cameronmorgzz-web/OpenFrontIOmobile/cad/renders/button.png

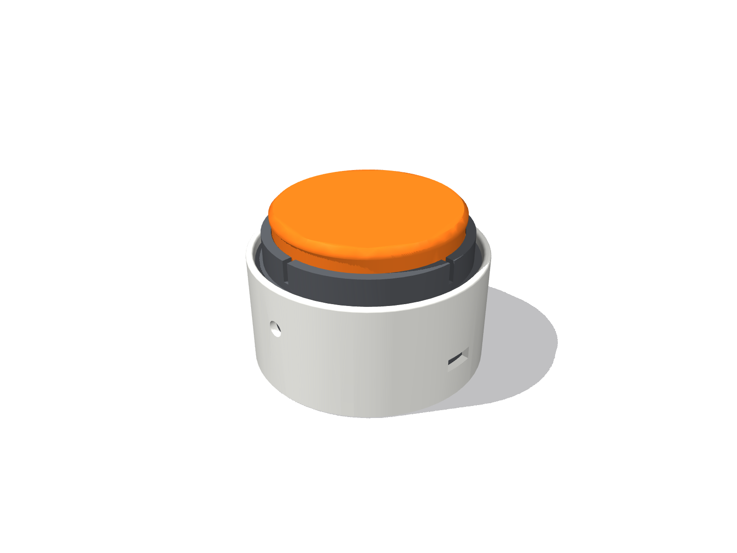
cad/renders/button.png
