cameronmorgzz-web/OpenFrontIOmobile/cad/renders/button_exploded.png

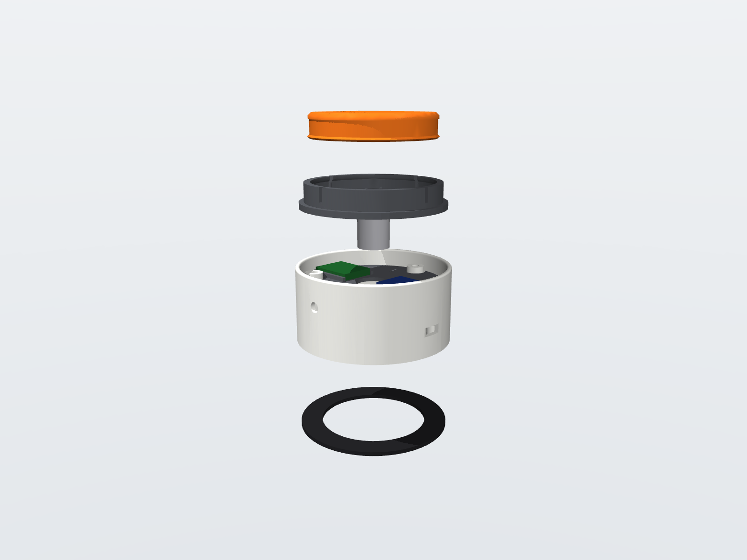
cad/renders/button_exploded.png
