cameronmorgzz-web/OpenFrontIOmobile/cad/renders/launcher_exploded.png

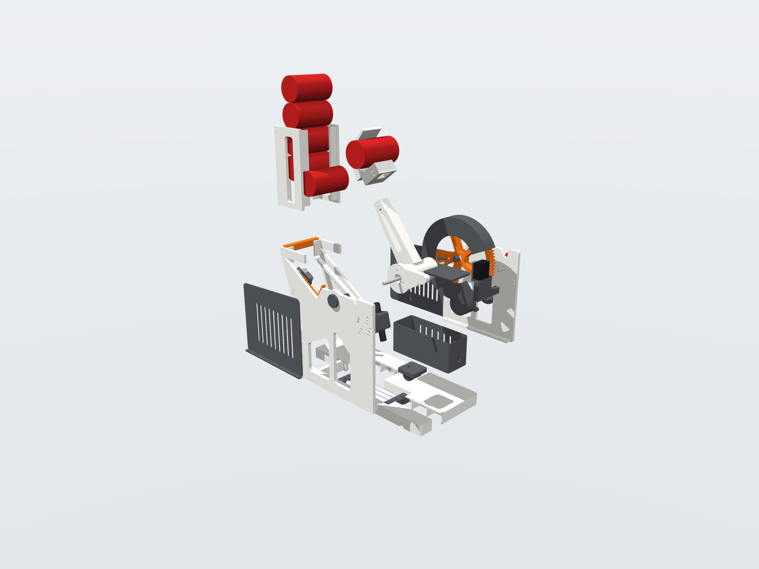
cad/renders/launcher_exploded.png
