cameronmorgzz-web/OpenFrontIOmobile/cad/renders/launcher_rear_right.png

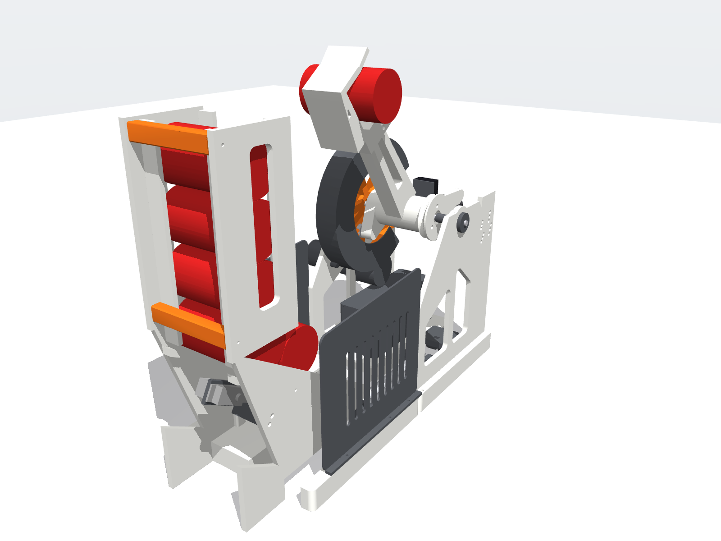
cad/renders/launcher_rear_right.png
