cameronmorgzz-web/OpenFrontIOmobile/cad/renders/launcher_side.png

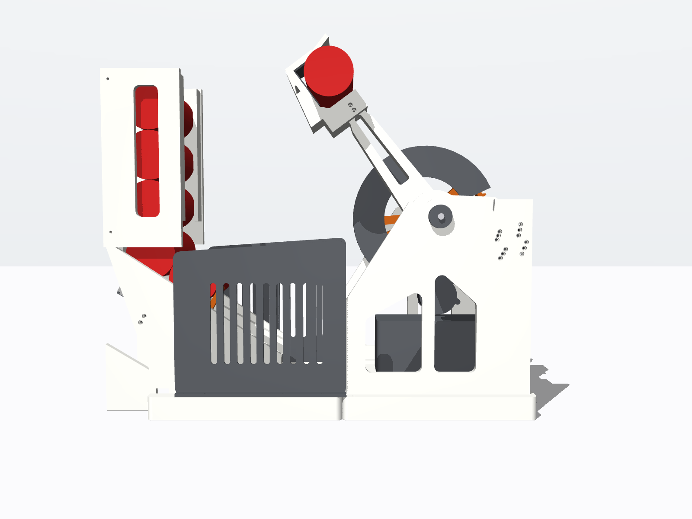
cad/renders/launcher_side.png
