cameronmorgzz-web/OpenFrontIOmobile/cad/renders/launcher_top.png

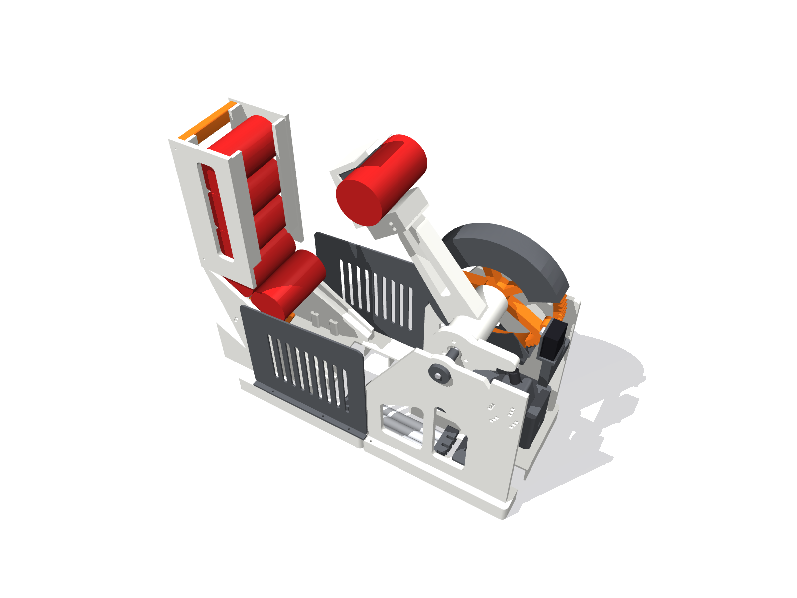
cad/renders/launcher_top.png
