cameronmorgzz-web/OpenFrontIOmobile/calc/plots/swing_4m.png

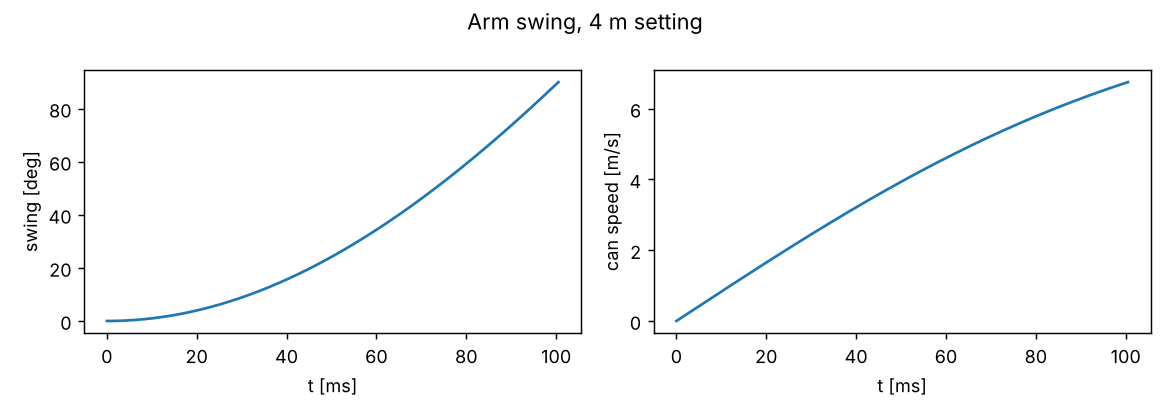
calc/plots/swing_4m.png
