cameronmorgzz-web/OpenFrontIOmobile/calc/plots/trajectories.png

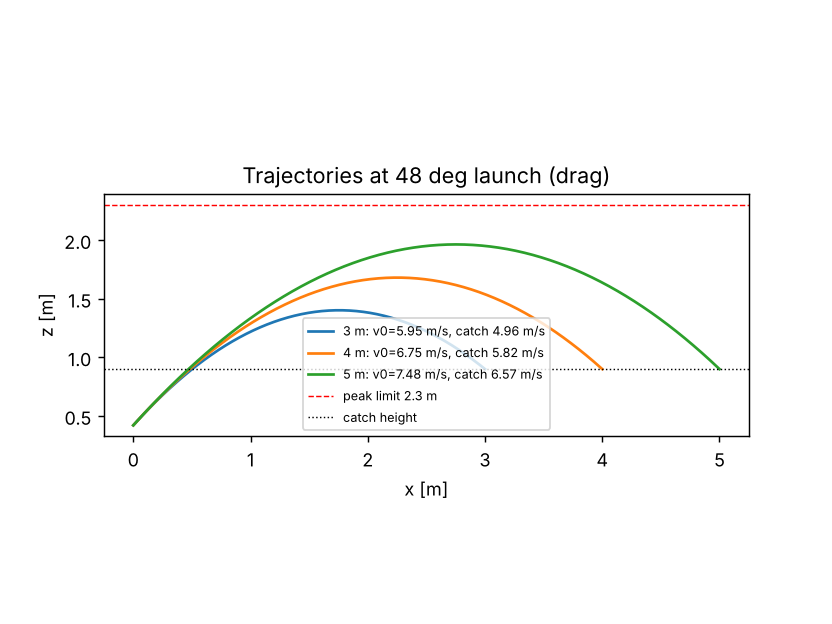
calc/plots/trajectories.png
