cameronmorgzz-web/OpenFrontIOmobile/sim/plots/feed_sim.png

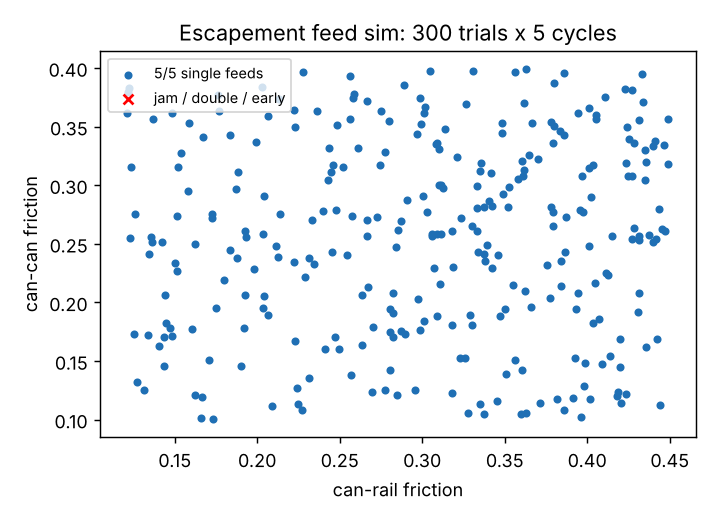
sim/plots/feed_sim.png
