cameronmorgzz-web/OpenFrontIOmobile/sim/plots/monte_carlo_4m.png

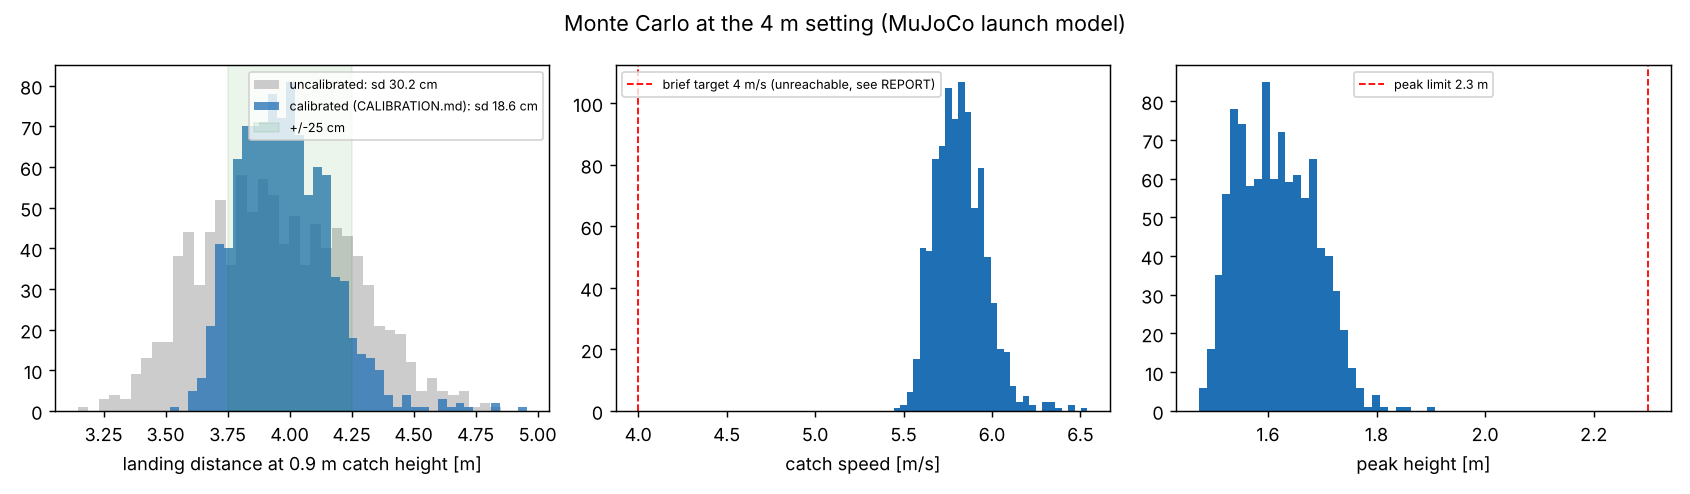
sim/plots/monte_carlo_4m.png
