cameronmorgzz-web/OpenFrontIOmobile/cad/step/launcher_assembly.step

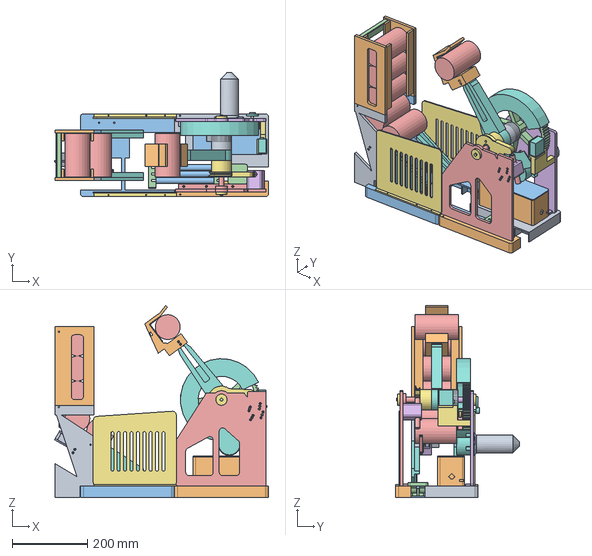
[picture p12: CAD file, 2026-10-26]
cad/step/launcher_assembly.step
568.7 x 330.0 x 510.2 mm
