cameronmorgzz-web/OpenFrontIOmobile/cad/3mf/plate_PETG_13.3mf

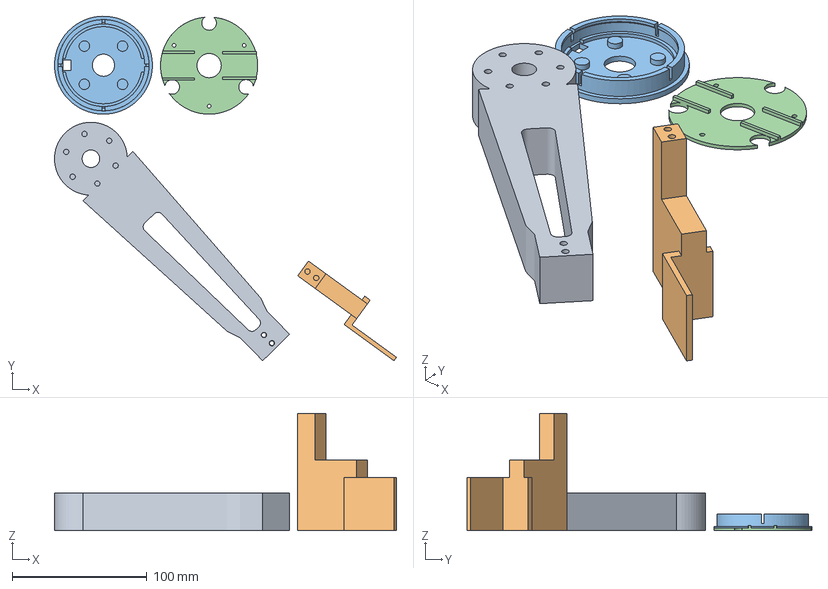
[picture p13: CAD file, 2026-10-26]
cad/3mf/plate_PETG_13.3mf
253.4 x 255.3 x 87.0 mm
arm
latch_servo_mount
btn_switch_plate
btn_tray
