cameronmorgzz-web/OpenFrontIOmobile/cad/step/btn_switch_plate.step

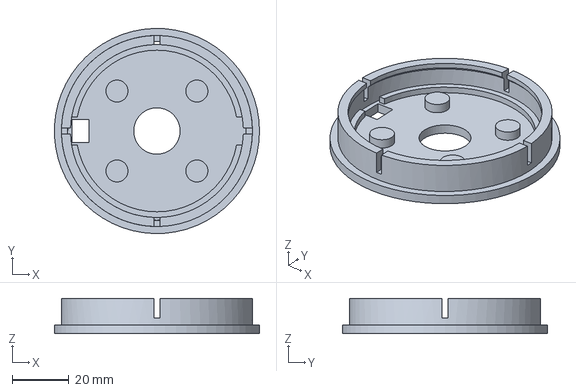
[picture p14: CAD file, 2026-10-26]
cad/step/btn_switch_plate.step
72.5 x 72.6 x 12.5 mm
