cameronmorgzz-web/OpenFrontIOmobile/cad/step/latch_servo_mount.step

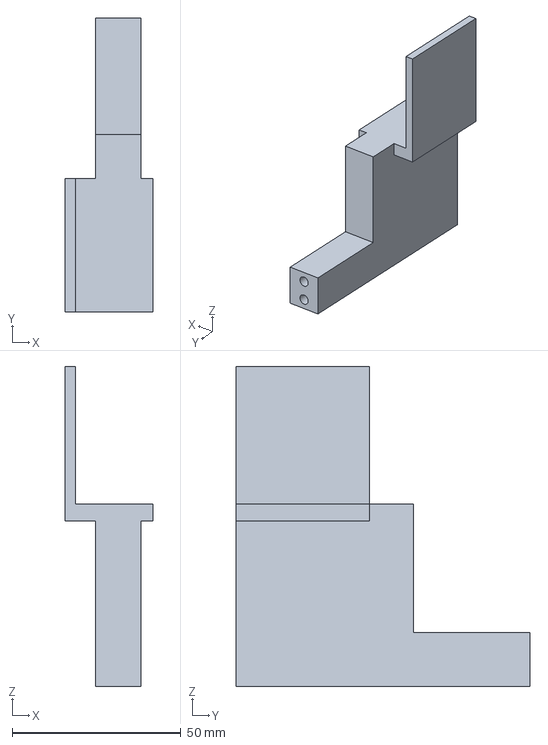
[picture p16: CAD file, 2026-10-26]
cad/step/latch_servo_mount.step
26.0 x 87.0 x 94.7 mm
