cameronmorgzz-web/OpenFrontIOmobile/cad/3mf/plate_PETG_8.3mf

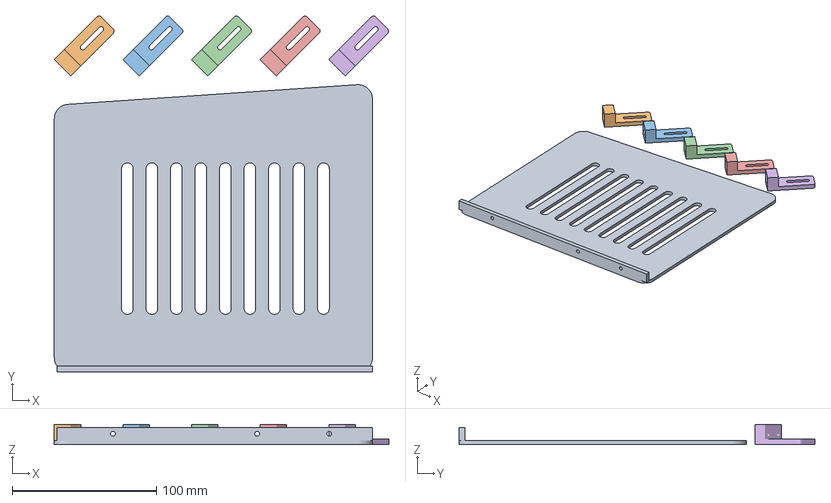
[picture p17: CAD file, 2026-10-26]
cad/3mf/plate_PETG_8.3mf
232.0 x 246.9 x 14.0 mm
side_cheek_left
switch_bracket x 5
