cameronmorgzz-web/OpenFrontIOmobile/cad/3mf/plate_PETG_6.3mf

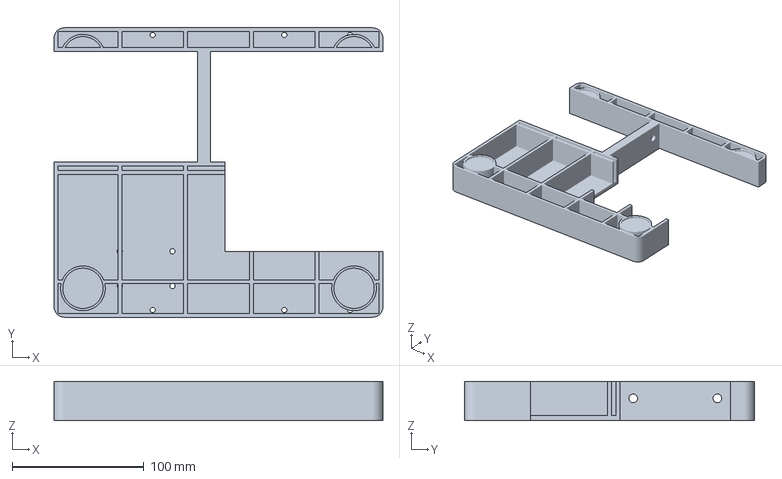
[picture p18: CAD file, 2026-10-26]
cad/3mf/plate_PETG_6.3mf
250.0 x 220.0 x 30.0 mm
