cameronmorgzz-web/OpenFrontIOmobile/cad/step/mag_chute_left.step

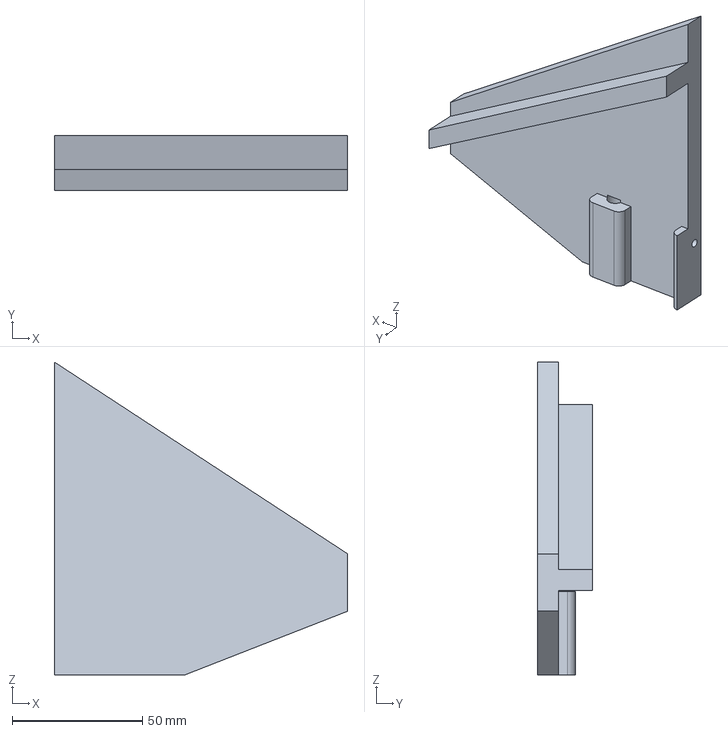
[picture p19: CAD file, 2026-10-26]
cad/step/mag_chute_left.step
112.5 x 21.0 x 120.1 mm
