cameronmorgzz-web/OpenFrontIOmobile/cad/3mf/plate_PETG_7.3mf

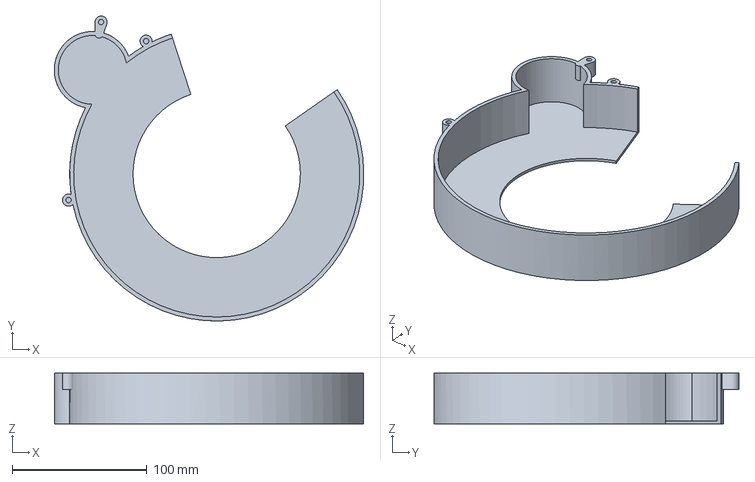
[picture p20: CAD file, 2026-10-26]
cad/3mf/plate_PETG_7.3mf
229.4 x 226.1 x 37.5 mm
