cameronmorgzz-web/OpenFrontIOmobile/cad/step/sensor_bracket.step

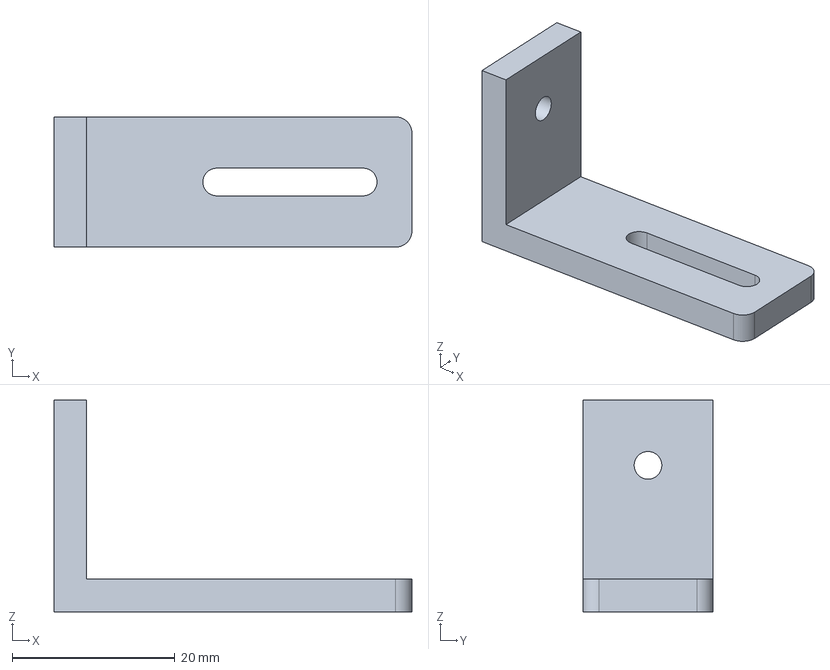
[picture p21: CAD file, 2026-10-26]
cad/step/sensor_bracket.step
44.0 x 16.0 x 26.0 mm
