cameronmorgzz-web/OpenFrontIOmobile/cad/3mf/plate_PETG_5.3mf

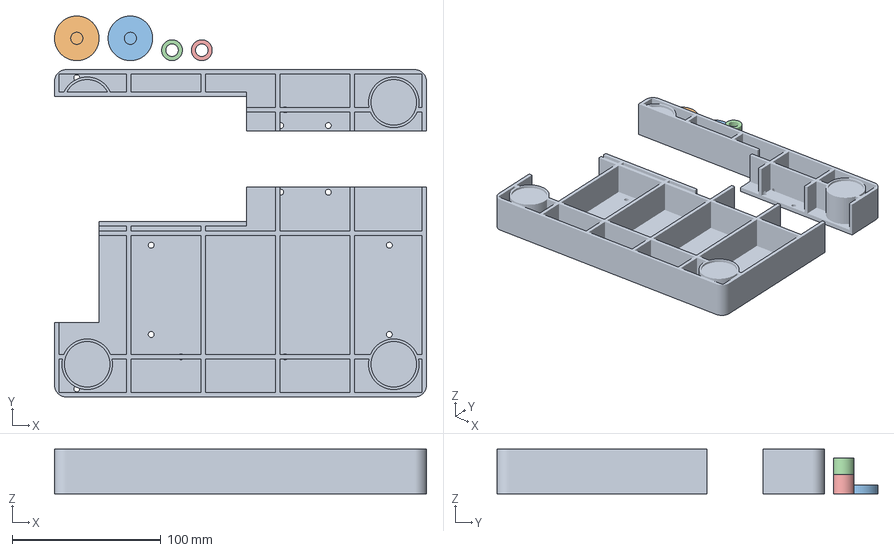
[picture p22: CAD file, 2026-10-26]
cad/3mf/plate_PETG_5.3mf
250.0 x 256.0 x 30.0 mm
base_front
shaft_cap_left
shaft_cap_right
shaft_spacer_left
shaft_spacer_mid
