cameronmorgzz-web/OpenFrontIOmobile/cad/3mf/plate_PETG_12.3mf

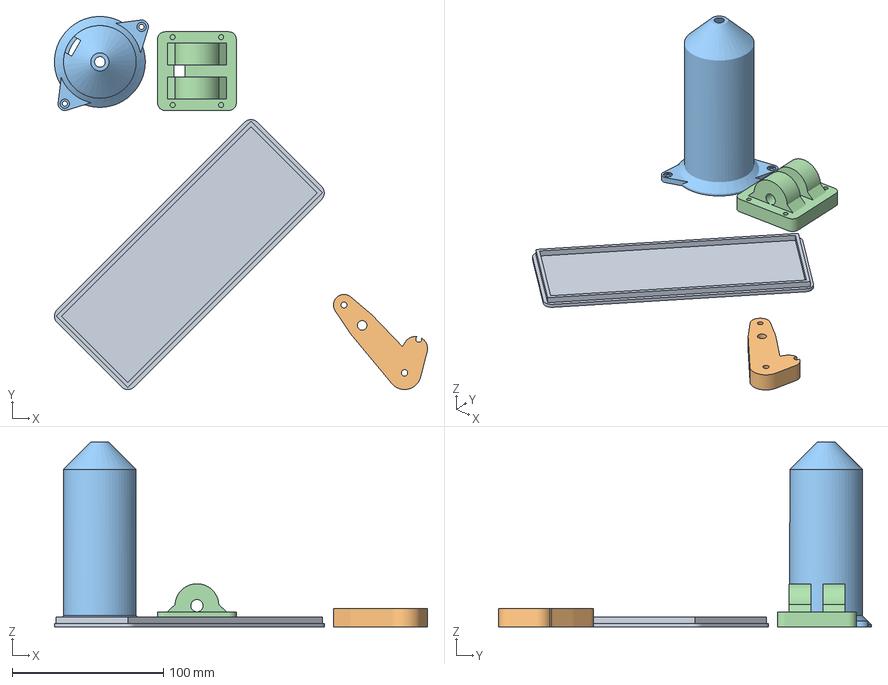
[picture p24: CAD file, 2026-10-26]
cad/3mf/plate_PETG_12.3mf
246.3 x 246.2 x 122.0 mm
ebox_lid
ring_latch
motor_cover
pulley_bracket
