cameronmorgzz-web/OpenFrontIOmobile/cad/step/ebox_lid.step

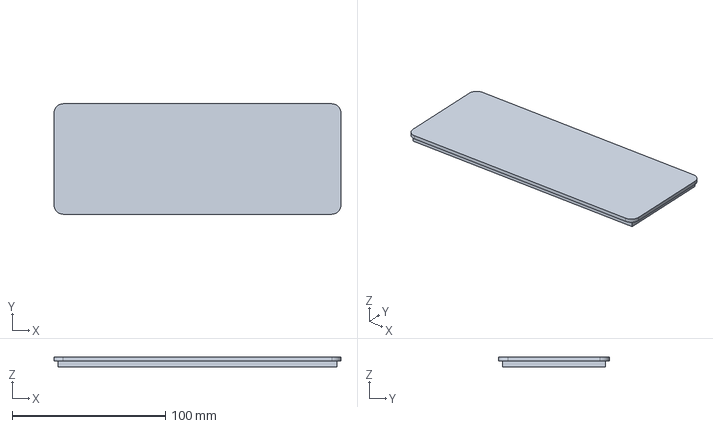
[picture p25: CAD file, 2026-10-26]
cad/step/ebox_lid.step
187.0 x 72.0 x 6.40 mm
