cameronmorgzz-web/OpenFrontIOmobile/cad/3mf/plate_PETG_16.3mf

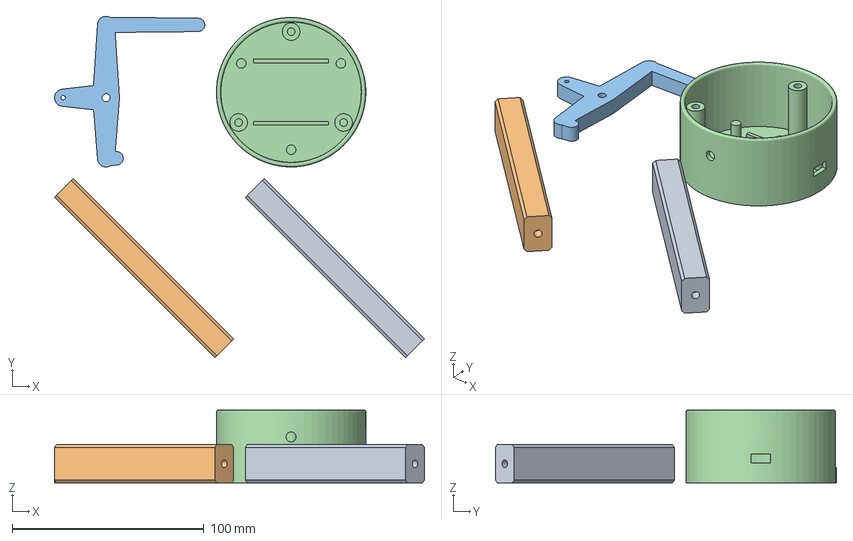
[picture p26: CAD file, 2026-10-26]
cad/3mf/plate_PETG_16.3mf
193.0 x 178.1 x 38.0 mm
mag_bridge_top
mag_bridge_back
escapement_rocker
btn_shell
