cameronmorgzz-web/OpenFrontIOmobile/cad/step/side_cheek_left.step

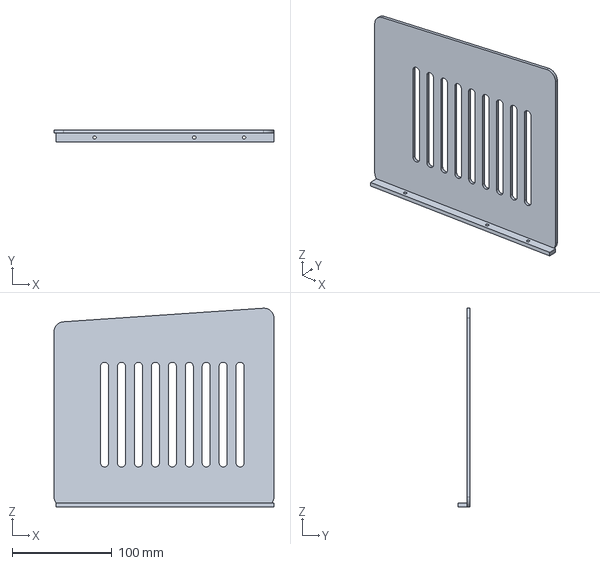
[picture p27: CAD file, 2026-10-26]
cad/step/side_cheek_left.step
220.7 x 12.0 x 199.3 mm
