cameronmorgzz-web/OpenFrontIOmobile/cad/3mf/plate_TPU_1.3mf

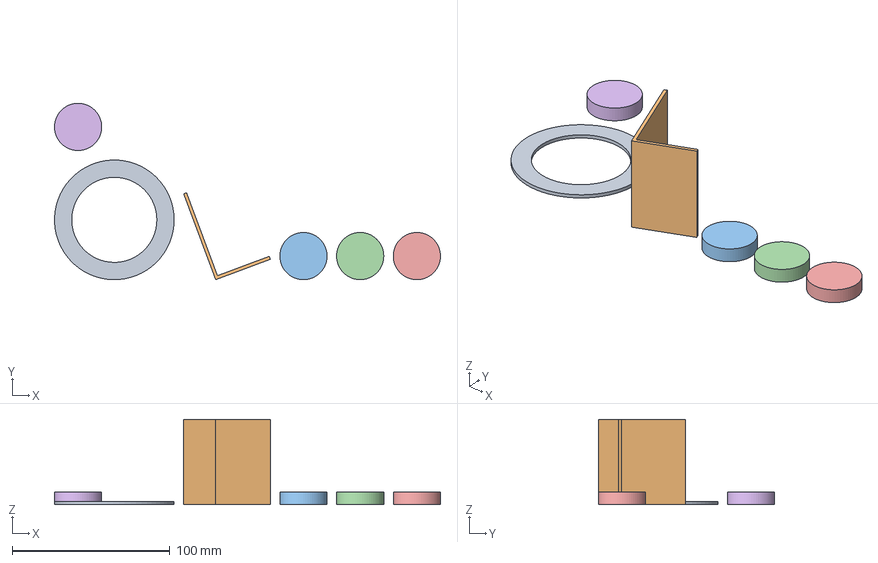
[picture p28: CAD file, 2026-10-26]
cad/3mf/plate_TPU_1.3mf
245.1 x 112.0 x 54.0 mm
btn_foot_ring
cup_pad
foot x 4
