cameronmorgzz-web/OpenFrontIOmobile/cad/step/ebox.step

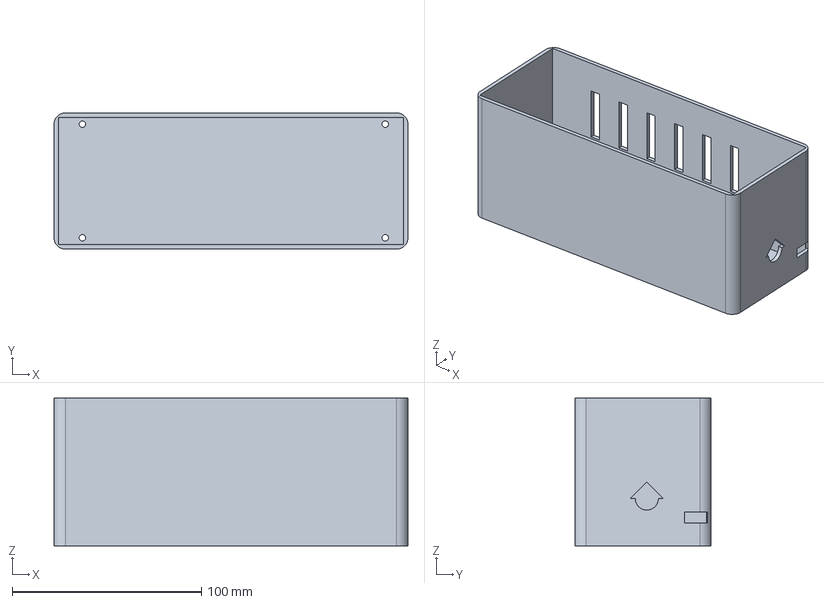
[picture p29: CAD file, 2026-10-26]
cad/step/ebox.step
187.0 x 72.0 x 78.0 mm
