cameronmorgzz-web/OpenFrontIOmobile/cad/3mf/plate_PETG_11.3mf

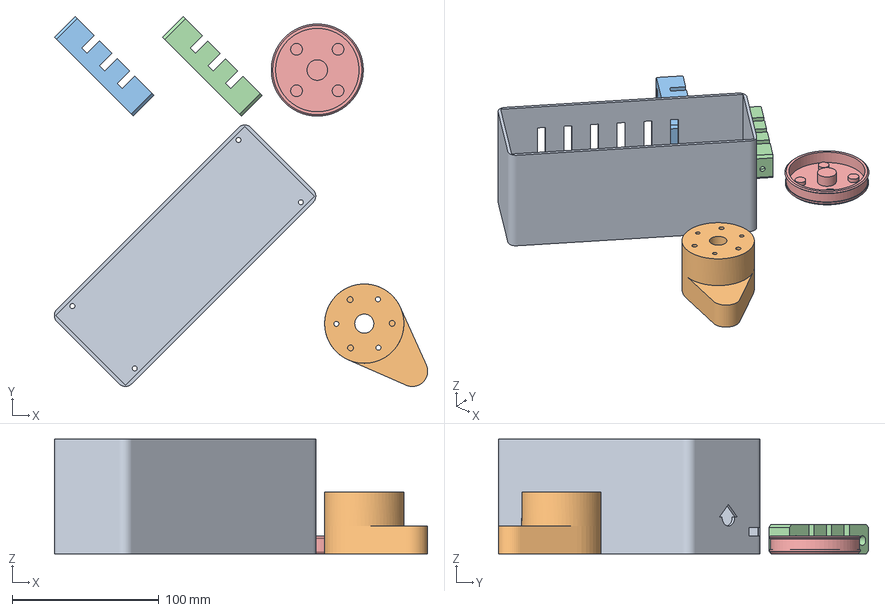
[picture p30: CAD file, 2026-10-26]
cad/3mf/plate_PETG_11.3mf
254.4 x 252.1 x 78.0 mm
ebox
hub_catch
spring_yoke_front
spring_yoke_rear
btn_cap
