cameronmorgzz-web/OpenFrontIOmobile/cad/step/mag_wall_right_upper.step

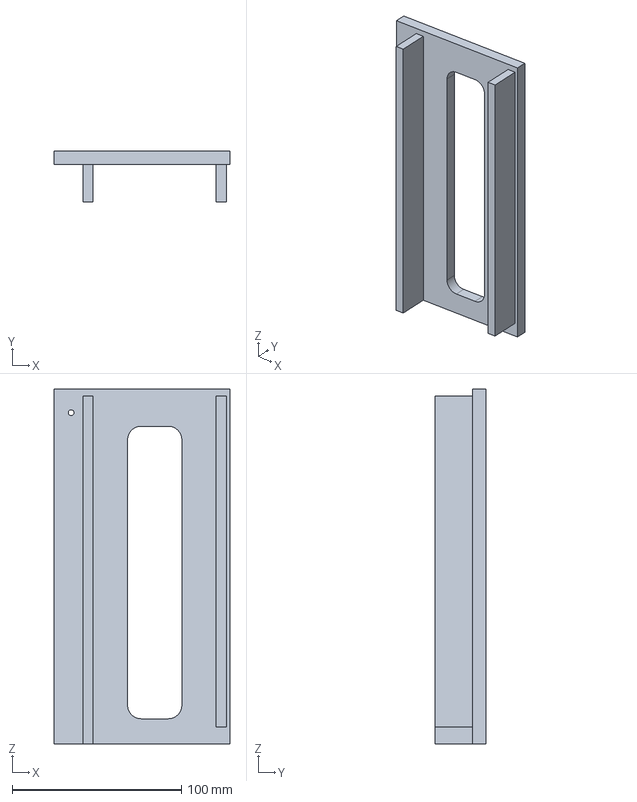
[picture p31: CAD file, 2026-10-26]
cad/step/mag_wall_right_upper.step
103.6 x 30.0 x 209.5 mm
