cameronmorgzz-web/OpenFrontIOmobile/cad/3mf/plate_PETG_15.3mf

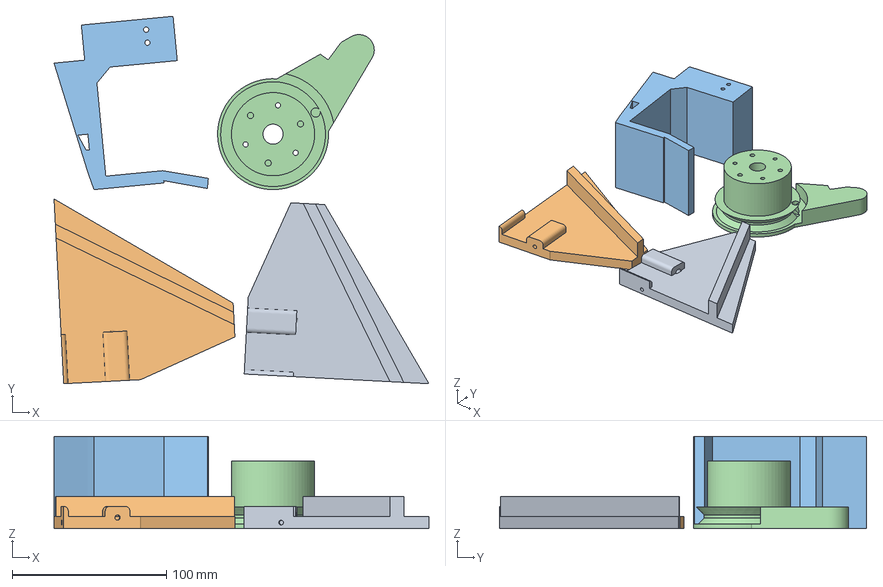
[picture p32: CAD file, 2026-10-26]
cad/3mf/plate_PETG_15.3mf
243.3 x 238.4 x 60.0 mm
mag_chute_left
mag_chute_right
cup
hub_drum
