cameronmorgzz-web/OpenFrontIOmobile/cad/step/pulley_bracket.step

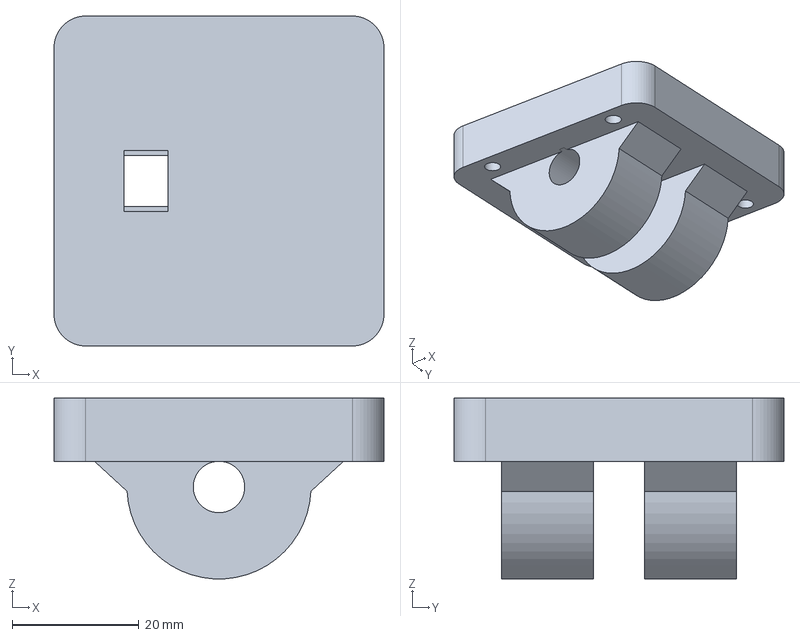
[picture p33: CAD file, 2026-10-26]
cad/step/pulley_bracket.step
52.0 x 52.0 x 28.5 mm
