cameronmorgzz-web/OpenFrontIOmobile/cad/3mf/plate_PETG_4.3mf

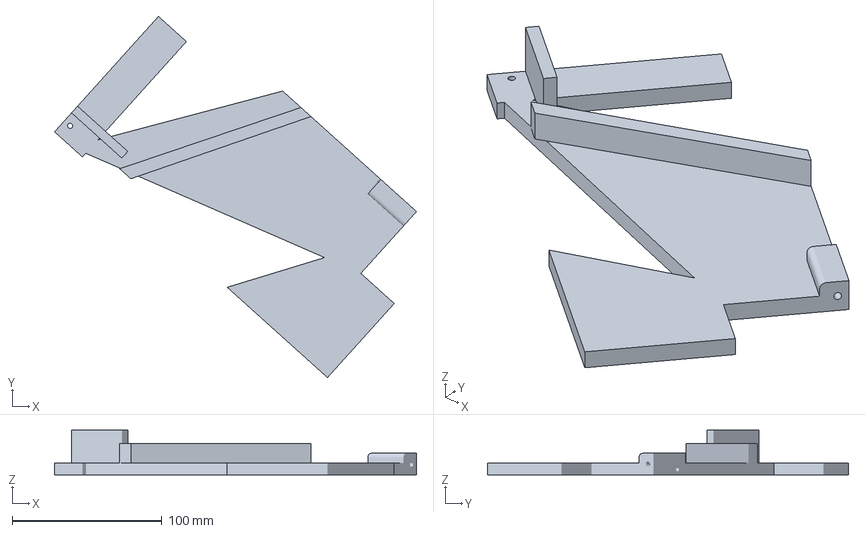
[picture p34: CAD file, 2026-10-26]
cad/3mf/plate_PETG_4.3mf
241.4 x 240.9 x 30.0 mm
