cameronmorgzz-web/OpenFrontIOmobile/cad/step/base_front.step

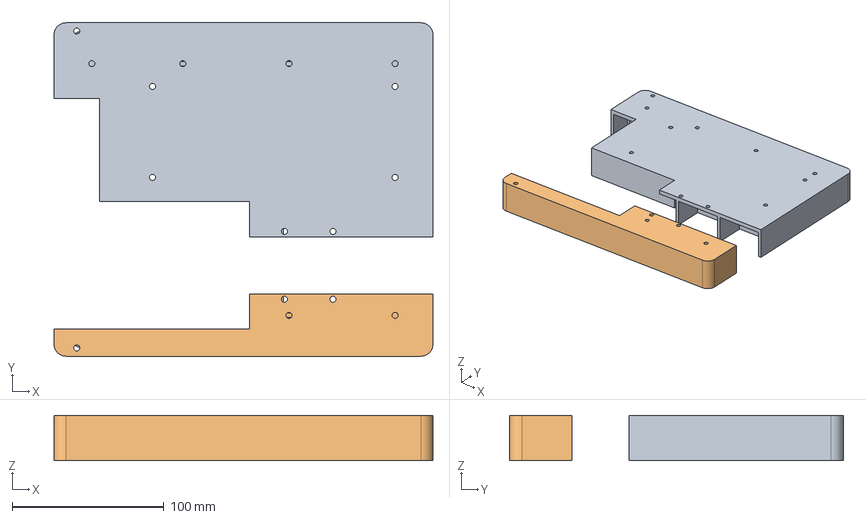
[picture p35: CAD file, 2026-10-26]
cad/step/base_front.step
250.0 x 220.0 x 30.0 mm
