cameronmorgzz-web/OpenFrontIOmobile/cad/3mf/plate_PETG_1.3mf

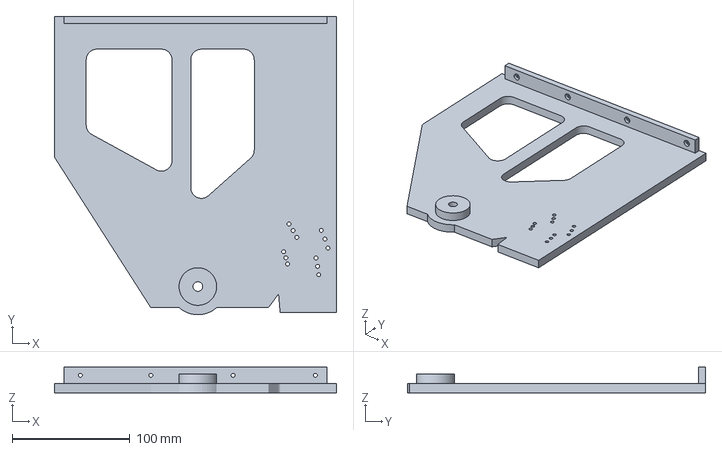
[picture p36: CAD file, 2026-10-26]
cad/3mf/plate_PETG_1.3mf
240.0 x 254.0 x 22.0 mm
