cameronmorgzz-web/OpenFrontIOmobile/cad/step/shaft_cap_left.step

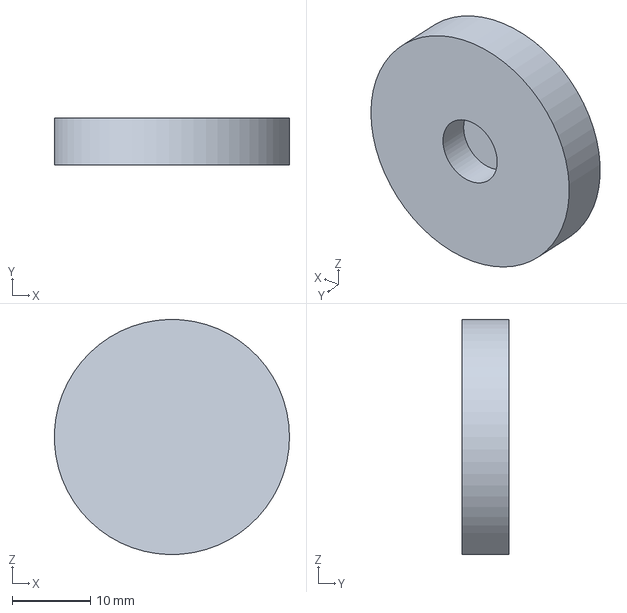
[picture p37: CAD file, 2026-10-26]
cad/step/shaft_cap_left.step
30.0 x 6.00 x 30.0 mm
