cameronmorgzz-web/OpenFrontIOmobile/cad/3mf/plate_PETG_9.3mf

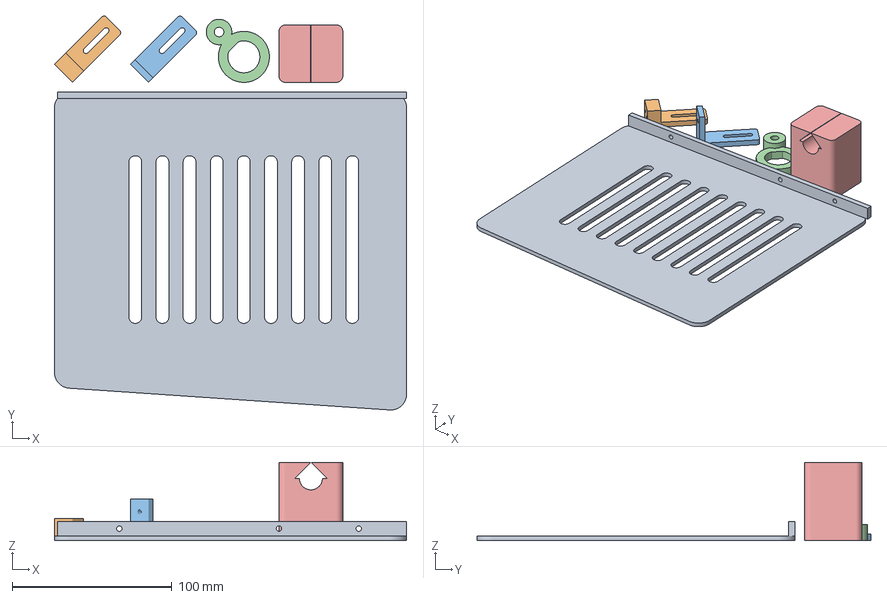
[picture p38: CAD file, 2026-10-26]
cad/3mf/plate_PETG_9.3mf
220.7 x 246.9 x 49.0 mm
side_cheek_right
switch_bracket
sensor_bracket
safety_pin_handle
stop_bracket
