cameronmorgzz-web/OpenFrontIOmobile/cad/step/mag_bridge_back.step

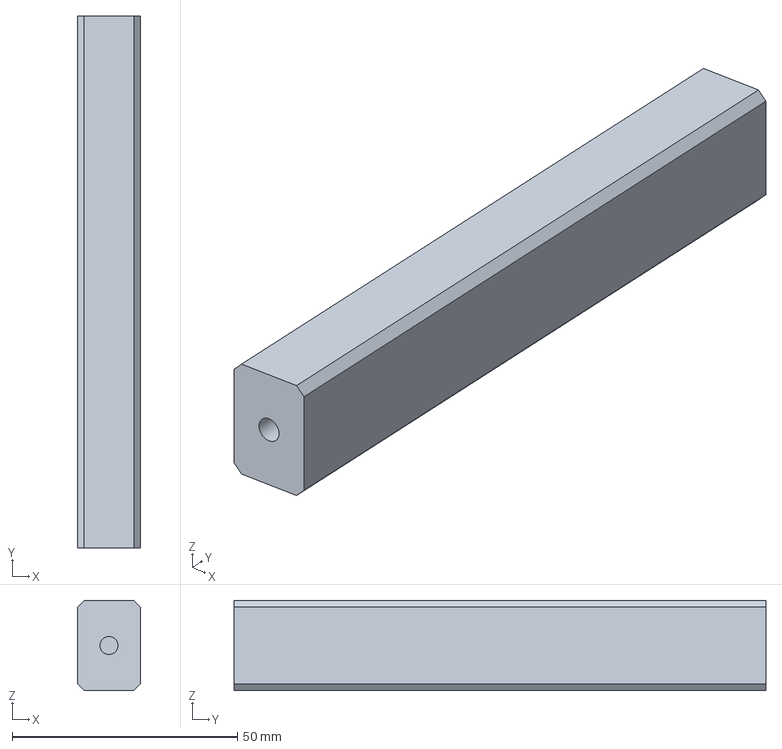
[picture p39: CAD file, 2026-10-26]
cad/step/mag_bridge_back.step
14.0 x 118.2 x 20.0 mm
