cameronmorgzz-web/OpenFrontIOmobile/cad/3mf/plate_PETG_14.3mf

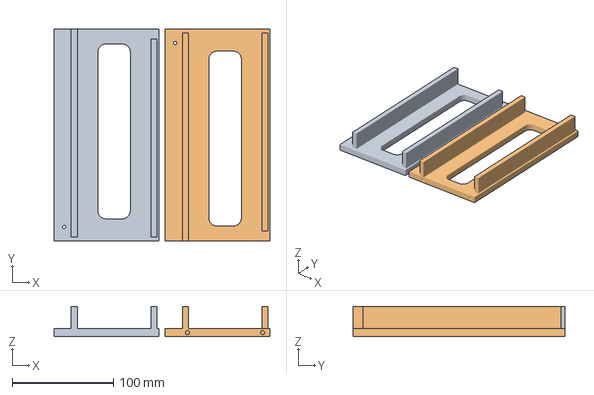
[picture p40: CAD file, 2026-10-26]
cad/3mf/plate_PETG_14.3mf
213.2 x 209.5 x 30.0 mm
mag_wall_left_upper
mag_wall_right_upper
