cameronmorgzz-web/OpenFrontIOmobile/cad/3mf/plate_PETG_10.3mf

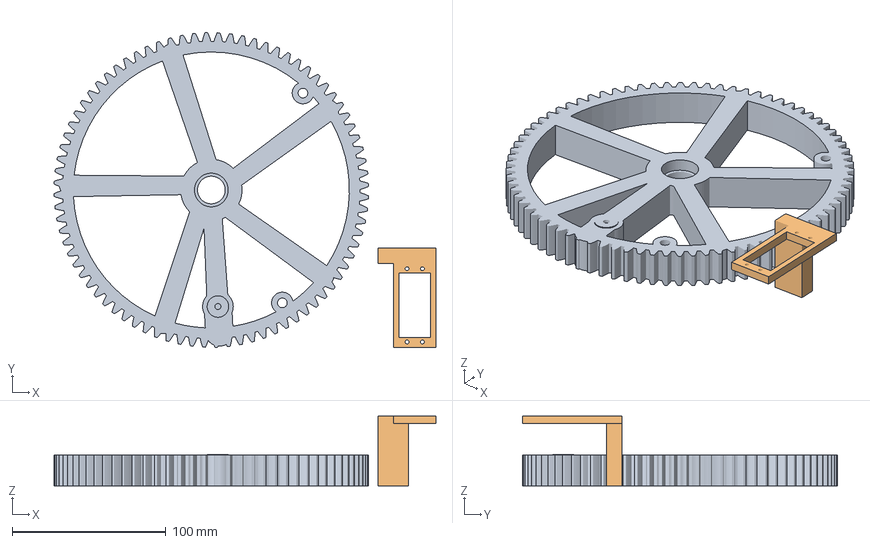
[picture p41: CAD file, 2026-10-26]
cad/3mf/plate_PETG_10.3mf
248.8 x 204.9 x 45.5 mm
ring_gear
esc_servo_mount
