cameronmorgzz-web/OpenFrontIOmobile/cad/step/gear_guard.step

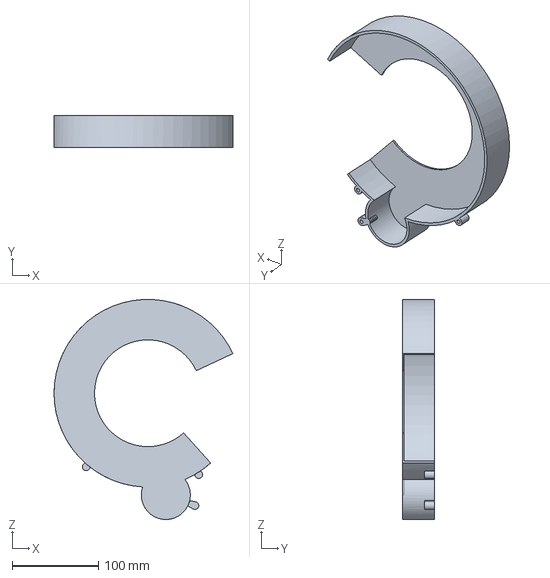
[picture p42: CAD file, 2026-10-26]
cad/step/gear_guard.step
207.8 x 37.5 x 255.5 mm
