cameronmorgzz-web/OpenFrontIOmobile/cad/step/escapement_rocker.step

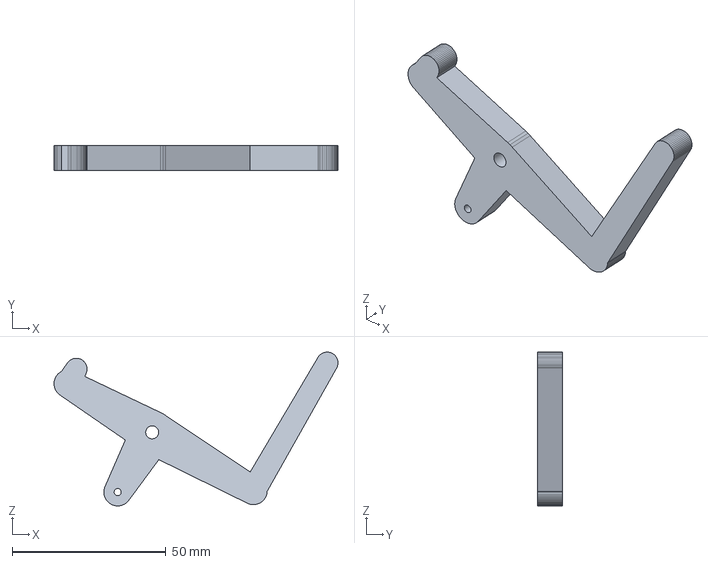
[picture p43: CAD file, 2026-10-26]
cad/step/escapement_rocker.step
92.3 x 8.00 x 50.0 mm
