cameronmorgzz-web/OpenFrontIOmobile/cad/step/shaft_spacer_mid.step

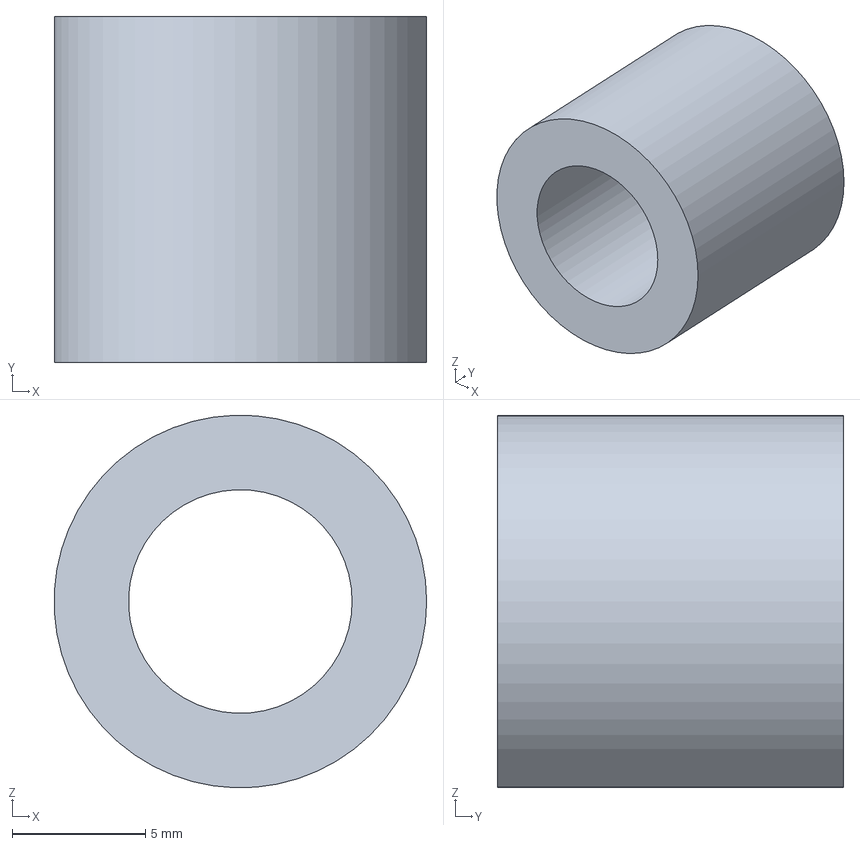
[picture p44: CAD file, 2026-10-26]
cad/step/shaft_spacer_mid.step
14.0 x 13.0 x 14.0 mm
