cameronmorgzz-web/OpenFrontIOmobile/cad/step/esc_servo_mount.step

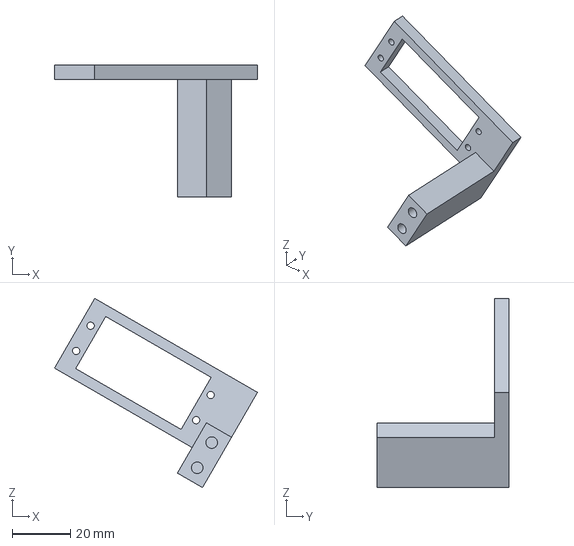
[picture p45: CAD file, 2026-10-26]
cad/step/esc_servo_mount.step
69.9 x 45.5 x 65.1 mm
