cameronmorgzz-web/OpenFrontIOmobile/cad/step/spring_yoke_front.step

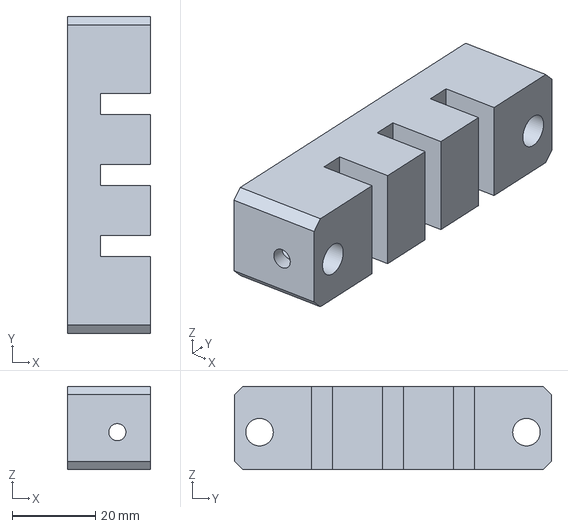
[picture p46: CAD file, 2026-10-26]
cad/step/spring_yoke_front.step
20.0 x 76.0 x 20.0 mm
