cameronmorgzz-web/OpenFrontIOmobile/cad/step/cup.step

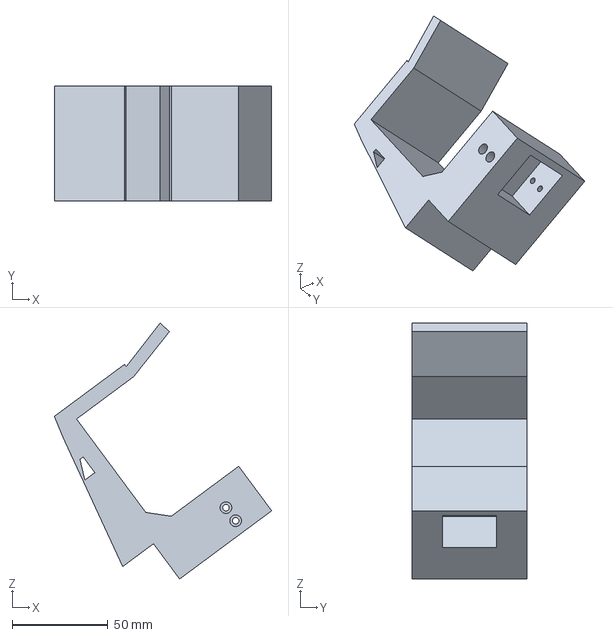
[picture p47: CAD file, 2026-10-26]
cad/step/cup.step
113.4 x 60.0 x 133.6 mm
