cameronmorgzz-web/OpenFrontIOmobile/cad/step/btn_shell.step

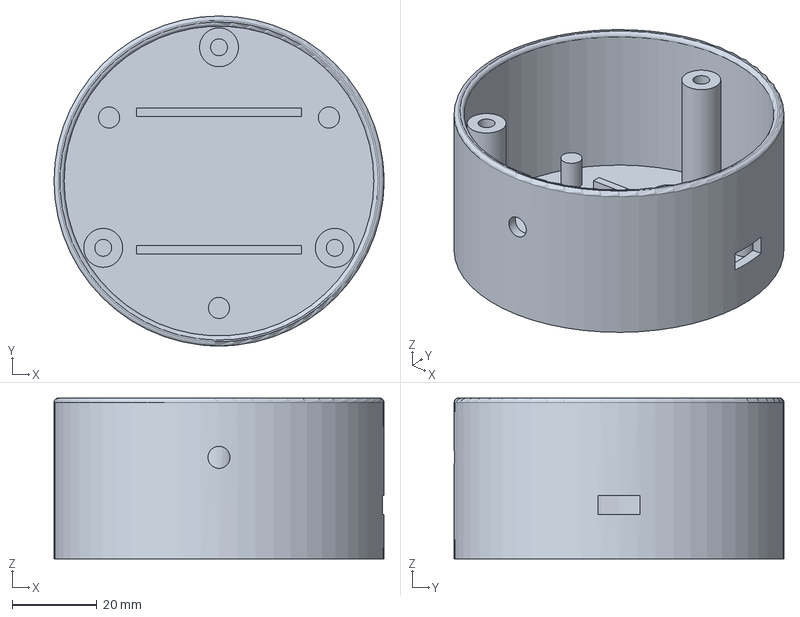
[picture p48: CAD file, 2026-10-26]
cad/step/btn_shell.step
78.0 x 78.0 x 38.0 mm
