cameronmorgzz-web/OpenFrontIOmobile/cad/step/cup_pad.step

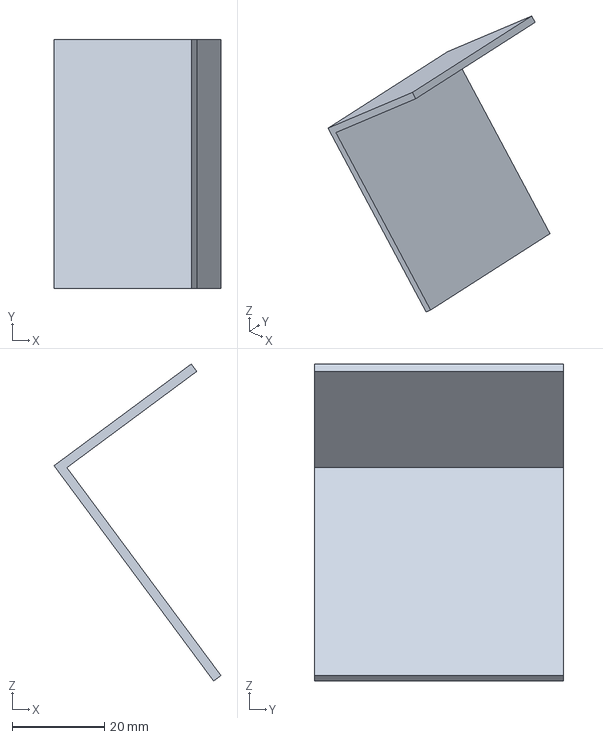
[picture p49: CAD file, 2026-10-26]
cad/step/cup_pad.step
36.3 x 54.0 x 68.8 mm
