cameronmorgzz-web/OpenFrontIOmobile/cad/step/btn_foot_ring.step

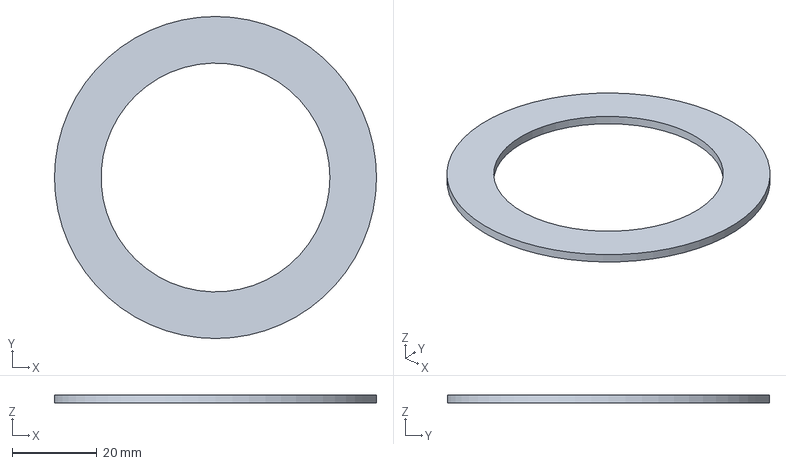
[picture p50: CAD file, 2026-10-26]
cad/step/btn_foot_ring.step
76.0 x 76.0 x 2.00 mm
