cameronmorgzz-web/OpenFrontIOmobile/cad/step/hub_drum.step

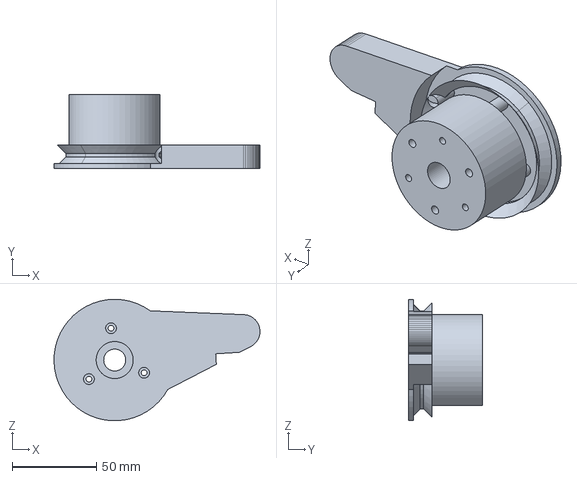
[picture p51: CAD file, 2026-10-26]
cad/step/hub_drum.step
122.1 x 44.0 x 72.0 mm
