cameronmorgzz-web/OpenFrontIOmobile/cad/step/shaft_spacer_left.step

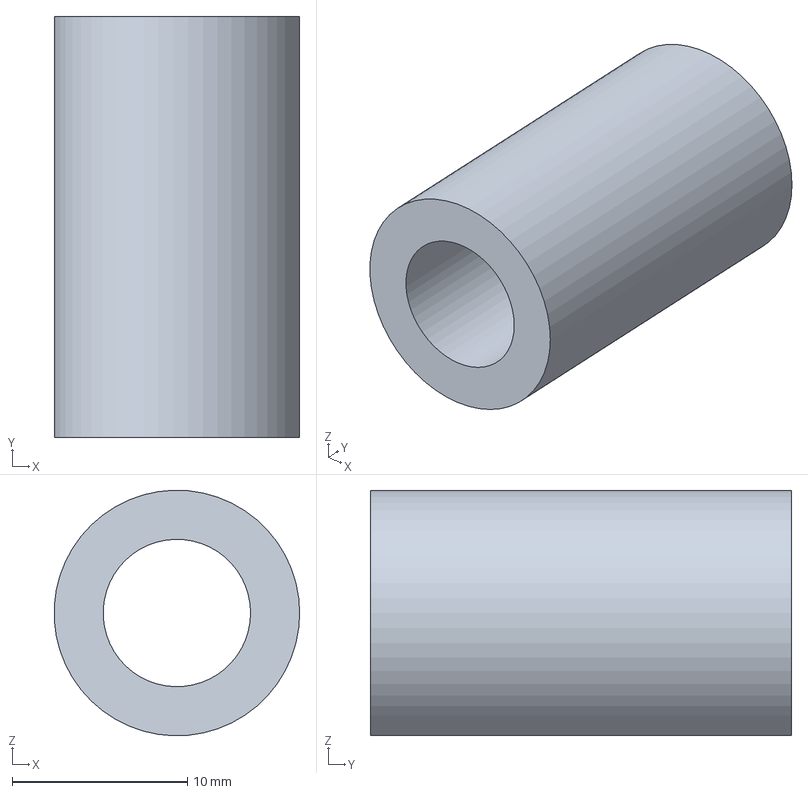
[picture p52: CAD file, 2026-10-26]
cad/step/shaft_spacer_left.step
14.0 x 24.0 x 14.0 mm
