cameronmorgzz-web/OpenFrontIOmobile/cad/step/btn_tray.step

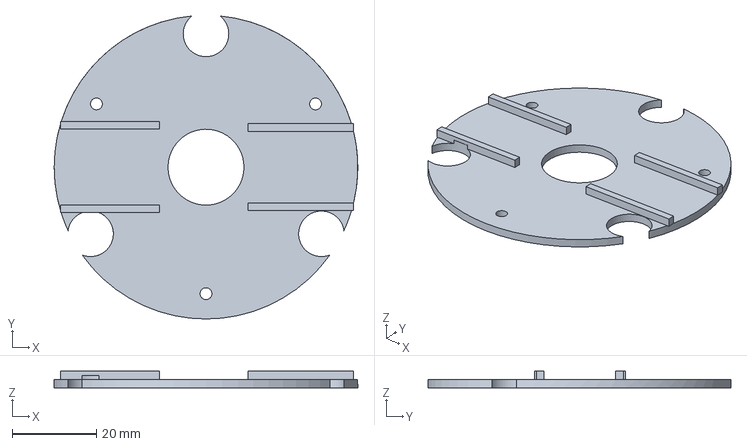
[picture p53: CAD file, 2026-10-26]
cad/step/btn_tray.step
72.0 x 71.8 x 4.00 mm
