cameronmorgzz-web/OpenFrontIOmobile/cad/step/ring_latch.step

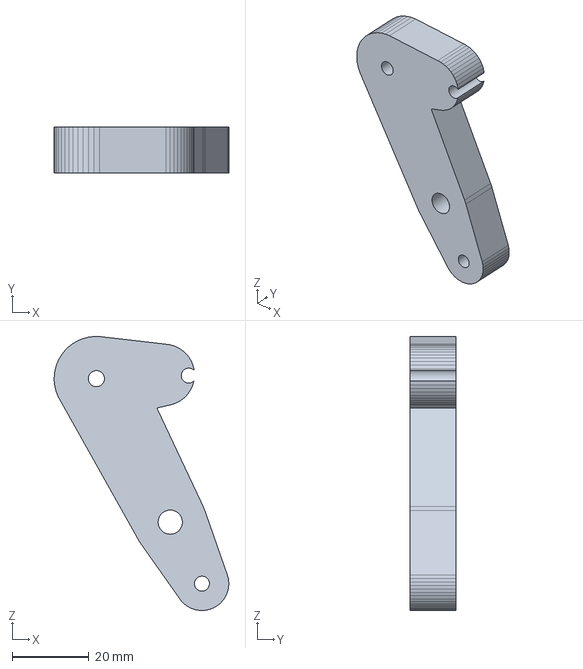
[picture p54: CAD file, 2026-10-26]
cad/step/ring_latch.step
45.4 x 12.0 x 71.3 mm
