cameronmorgzz-web/OpenFrontIOmobile/cad/step/hub_catch.step

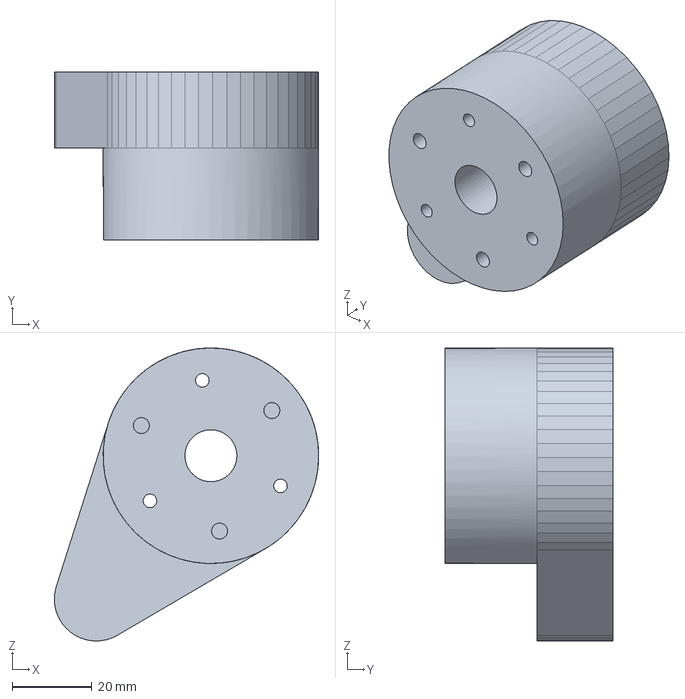
[picture p55: CAD file, 2026-10-26]
cad/step/hub_catch.step
66.2 x 42.0 x 73.4 mm
