cameronmorgzz-web/OpenFrontIOmobile/cad/step/foot.step

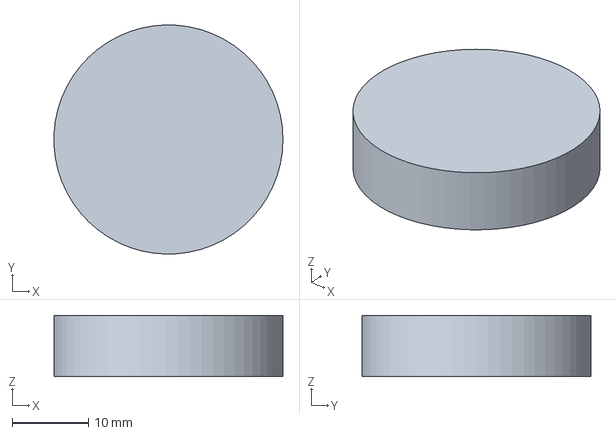
[picture p56: CAD file, 2026-10-26]
cad/step/foot.step
30.0 x 30.0 x 8.00 mm
