cameronmorgzz-web/OpenFrontIOmobile/cad/step/mag_wall_left_lower.step

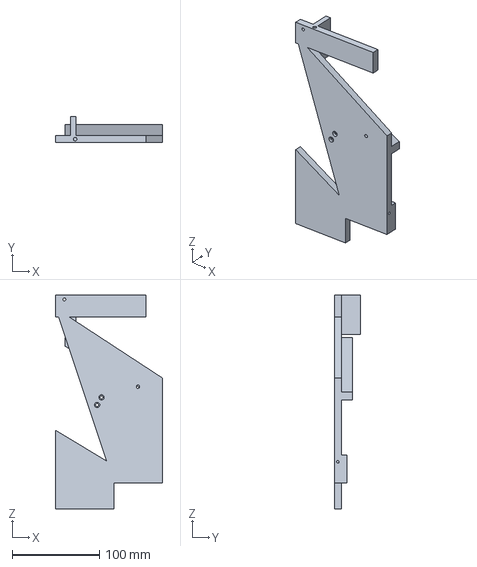
[picture p57: CAD file, 2026-10-26]
cad/step/mag_wall_left_lower.step
122.0 x 30.0 x 245.0 mm
