cameronmorgzz-web/OpenFrontIOmobile/cad/step/motor_cover.step

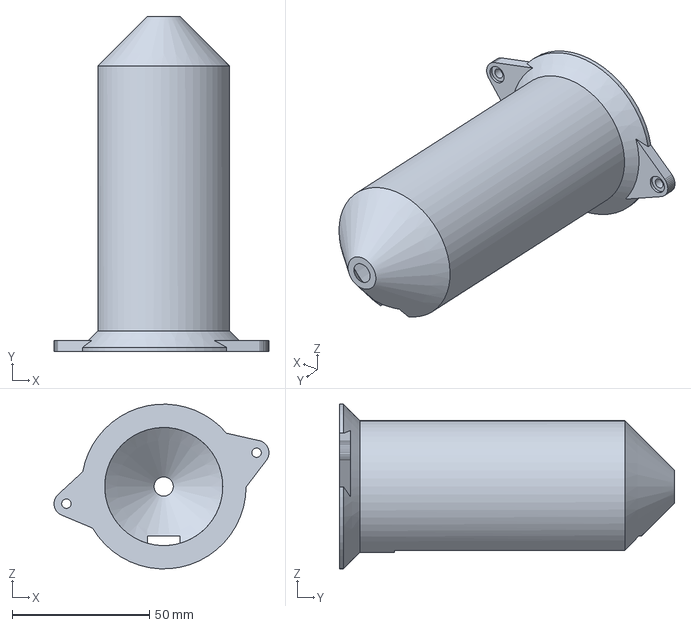
[picture p58: CAD file, 2026-10-26]
cad/step/motor_cover.step
78.3 x 122.0 x 59.9 mm
