cameronmorgzz-web/OpenFrontIOmobile/cad/step/ring_gear.step

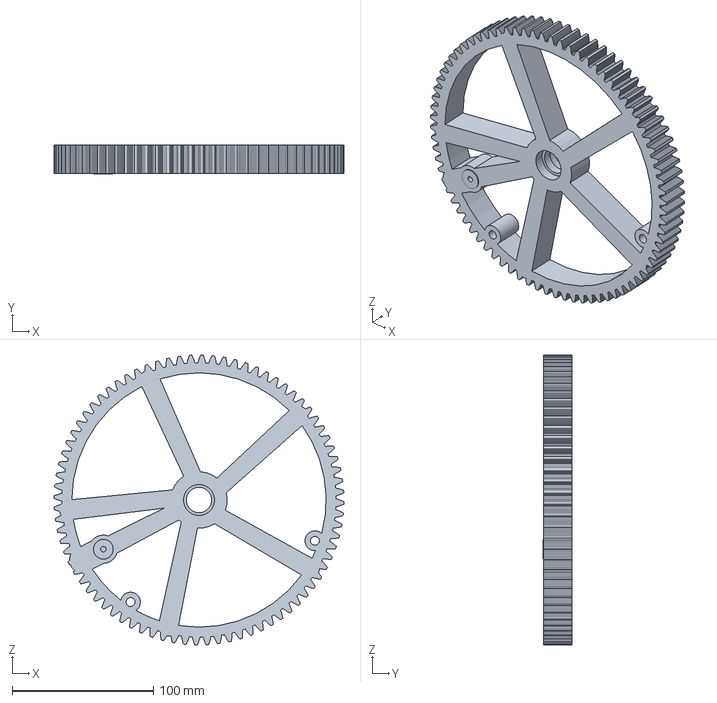
[picture p59: CAD file, 2026-10-26]
cad/step/ring_gear.step
205.0 x 20.5 x 205.0 mm
