cameronmorgzz-web/OpenFrontIOmobile/cad/step/stop_bracket.step

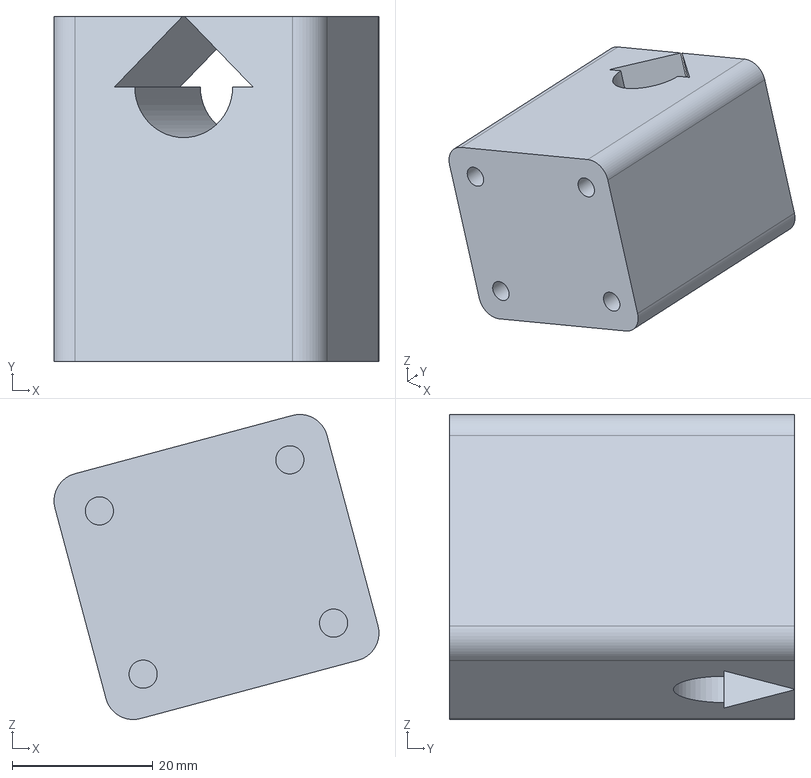
[picture p60: CAD file, 2026-10-26]
cad/step/stop_bracket.step
46.2 x 49.0 x 43.3 mm
