cameronmorgzz-web/OpenFrontIOmobile/cad/step/btn_cap.step

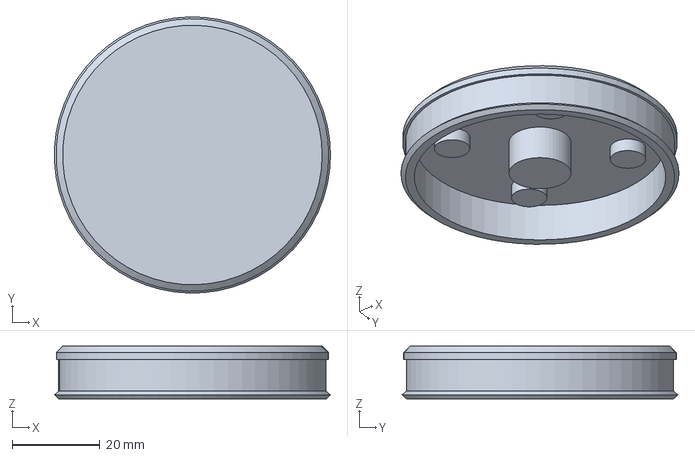
[picture p61: CAD file, 2026-10-26]
cad/step/btn_cap.step
62.8 x 62.8 x 12.0 mm
