cameronmorgzz-web/OpenFrontIOmobile/cad/step/arm.step

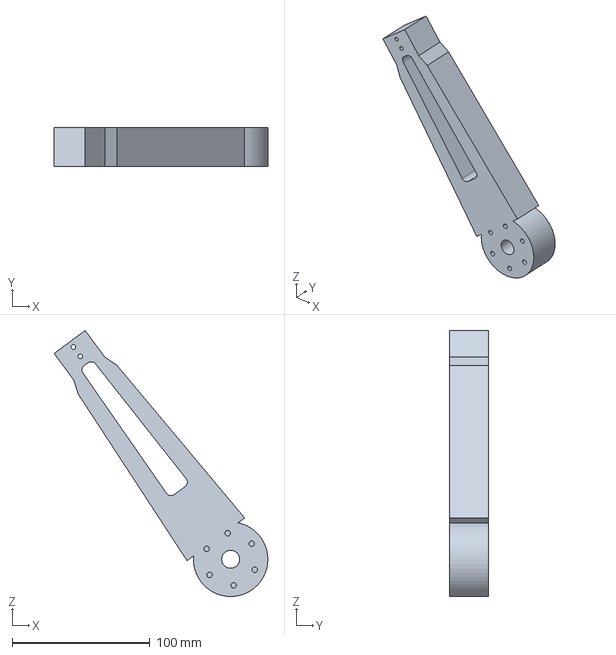
[picture p62: CAD file, 2026-10-26]
cad/step/arm.step
154.9 x 28.0 x 192.8 mm
