cameronmorgzz-web/OpenFrontIOmobile/cad/step/safety_pin_handle.step

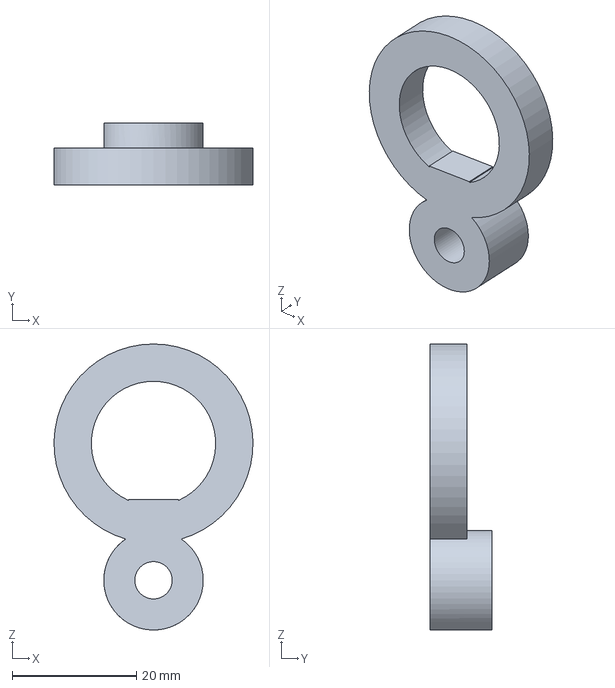
[picture p63: CAD file, 2026-10-26]
cad/step/safety_pin_handle.step
32.0 x 10.0 x 46.0 mm
