cameronmorgzz-web/OpenFrontIOmobile/cad/step/switch_bracket.step

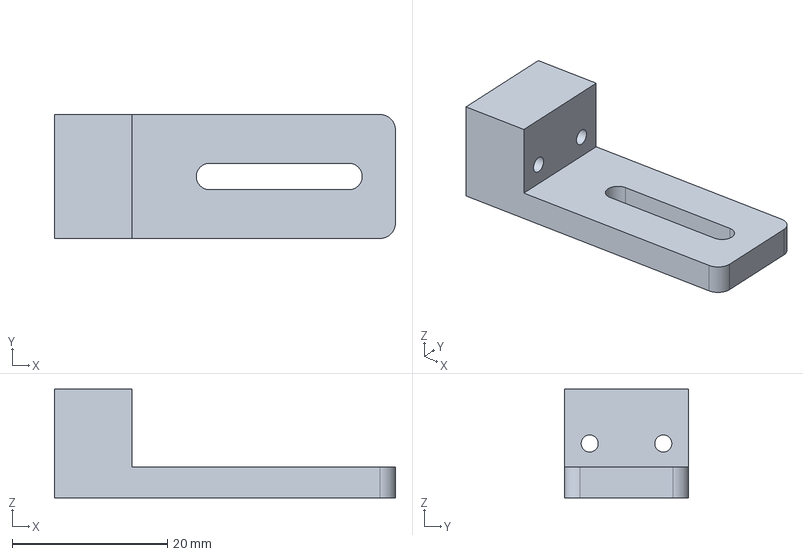
[picture p64: CAD file, 2026-10-26]
cad/step/switch_bracket.step
44.0 x 16.0 x 14.0 mm
