cameronmorgzz-web/OpenFrontIOmobile/(list of files, cad)

Other CAD files:
cad/step/side_plate_right.step
cad/3mf/plate_PETG_3.3mf
cad/step/side_plate_left.step
cad/step/side_cheek_right.step
cad/step/mag_bridge_top.step
cad/step/shaft_cap_right.step
cad/step/base_rear.step
cad/step/mag_chute_right.step
cad/step/mag_wall_left_upper.step
cad/step/spring_yoke_rear.step
cad/stl/arm.stl
cad/stl/base_front.stl
cad/stl/base_rear.stl
cad/stl/btn_cap.stl
cad/stl/btn_foot_ring.stl
cad/stl/btn_shell.stl
cad/stl/btn_switch_plate.stl
cad/stl/btn_tray.stl
cad/stl/cup.stl
cad/stl/cup_pad.stl
cad/stl/ebox.stl
cad/stl/ebox_lid.stl
cad/stl/esc_servo_mount.stl
cad/stl/escapement_rocker.stl
cad/stl/foot.stl
cad/stl/gear_guard.stl
cad/stl/hub_catch.stl
cad/stl/hub_drum.stl
cad/stl/latch_servo_mount.stl
cad/stl/mag_bridge_back.stl
cad/stl/mag_bridge_top.stl
cad/stl/mag_chute_left.stl
cad/stl/mag_chute_right.stl
cad/stl/mag_wall_left_lower.stl
cad/stl/mag_wall_left_upper.stl
cad/stl/mag_wall_right_lower.stl
cad/stl/mag_wall_right_upper.stl
cad/stl/motor_cover.stl
cad/stl/pulley_bracket.stl
cad/stl/ring_gear.stl
cad/stl/ring_latch.stl
cad/stl/safety_pin_handle.stl
cad/stl/sensor_bracket.stl
cad/stl/shaft_cap_left.stl
cad/stl/shaft_cap_right.stl
cad/stl/shaft_spacer_left.stl
cad/stl/shaft_spacer_mid.stl
cad/stl/side_cheek_left.stl
cad/stl/side_cheek_right.stl
cad/stl/side_plate_left.stl
cad/stl/side_plate_right.stl
cad/stl/spring_yoke_front.stl
cad/stl/spring_yoke_rear.stl
cad/stl/stop_bracket.stl
cad/stl/switch_bracket.stl
