cameronmorgzz-web/OpenFrontIOmobile/calc/RESULTS.md

# Phase 2 — analytical results (generated by `python -m calc.run_all`)

Mass properties: **CAD (cad/mass_props.json)**. Every number below is produced by the code in `calc/`; equations are in each module's docstring, sources in `research/SOURCES.md`.

## 1. Ballistics (quadratic drag, `calc/ballistics.py`)

Release height 0.421 m (pivot 260.0 mm + arm 240.0 mm at alpha=138.0 deg), catch height 0.9 m, Cd=0.7, A=0.00763 m2.

| range m | launch angle | v0 m/s | catch speed m/s | peak height m | flight s | vacuum min catch speed m/s | min-catch-speed angle (drag) |
|---|---|---|---|---|---|---|---|
| 3 | 48 deg | 5.95 | 4.96 | 1.40 | 0.77 | 5.01 | 49.2 deg (4.96 m/s) |
| 4 | 48 deg | 6.75 | 5.82 | 1.68 | 0.90 | 5.90 | 47.9 deg (5.82 m/s) |
| 5 | 48 deg | 7.48 | 6.57 | 1.96 | 1.03 | 6.68 | 47.1 deg (6.56 m/s) |

**Target conflict (physics):** the lowest possible catch speed for a given range is the minimum-energy shot; in vacuum `v_c^2 = g(sqrt(R^2+dh^2) - dh)`. With dh = 0.48 m, catch speed <= 4 m/s is only reachable up to R = **2.06 m**. At 4 m the floor is 5.90 m/s (vacuum) / 5.82 m/s (with drag). No launcher can meet both 4 m and 4 m/s; we fly the minimum-catch-speed arc (48 deg detent is within 0.1 deg of optimum) — see DECISIONS.md D2.

## 2. Spring -> arm -> can (`calc/arm_dynamics.py`)

3 x Gutekunst Z-141HI (R=1.2 N/mm, F0=14.5 N, Fn=166.7 N, sn=126.84 mm), drum r=30.0 mm, swing 90.0 deg, I_arm=0.0079 kg m2.

| range | preload x_rest mm | max ext mm | F_max/spring N (% Fn) | spring E J | can KE J | arm KE J | gravity J | friction J | efficiency | release m/s | swing ms | peak can accel m/s2 (g) | min back-wall force N |
|---|---|---|---|---|---|---|---|---|---|---|---|---|---|
| 3 m | 29.1 | 76.3 | 106 (64%) | 10.99 | 6.27 | 2.45 | 1.69 | 0.58 | 0.57 | 5.95 | 111 | 150 (15.3 g) | 12.5 |
| 4 m | 44.8 | 92.0 | 125 (75%) | 13.65 | 8.09 | 3.16 | 1.69 | 0.72 | 0.59 | 6.75 | 100 | 194 (19.8 g) | 17.3 |
| 5 m | 60.9 | 108.0 | 144 (86%) | 16.38 | 9.94 | 3.88 | 1.69 | 0.86 | 0.61 | 7.48 | 92 | 240 (24.5 g) | 22.2 |

Preload adjustment needed 3->5 m: **31.8 mm** of anchor travel (available 70 mm on the M6 adjusters; M6 pitch 1.0 mm -> 32 turns). Sensitivity at 4 m: 0.063 m range per mm preload.

### 500 ml can (CAN_SIZE='500')

- 3 m: preload 51.4 mm, spring 133 N (80% Fn) -> OK
- 4 m: preload 72.5 mm, spring 158 N (95% Fn) -> NOT ALLOWED (exceeds 85% Fn)
- 5 m: preload 94.0 mm, spring 184 N (110% Fn) -> NOT ALLOWED (exceeds 85% Fn)

## 3. Cocking motor (`calc/motor.py`)

37GB555 12V 30:1 + Hall encoder: no-load 133.0 rpm, rated 0.98 N m @ 100.0 rpm, derived stall 3.95 N m / 5.3 A, R=2.27 ohm. Printed stage 16:80 = 5.0, eta=0.85.

| range | t_cock s | t_retract s | peak motor torque N m (% stall) | peak current A | peak ring torque N m | press->launch s | min fire->fire s | I_rms (8 s cycle) / rated |
|---|---|---|---|---|---|---|---|---|
| 3 m | 1.12 | 0.64 | 2.30 (58%) | 3.18 | 9.8 | **2.16** | 2.84 | 0.90/1.5 = 0.60 |
| 4 m | 1.38 | 0.64 | 2.72 (69%) | 3.71 | 11.6 | **2.42** | 3.10 | 1.22/1.5 = 0.82 |
| 5 m | 1.82 | 0.64 | 3.15 (80%) | 4.26 | 13.4 | **2.86** | 3.54 | 1.68/1.5 = 1.12 |

Latency budget: button wake+TX 0.25s, radio 0.01s, cock, feed 0.6s, settle 0.05s, latch trip 0.08s (the ring returns to park during RESET, after the shot, so it is not in the latency path); the 1.5 s warning starts with the motor (cocking is fully enclosed) and FIRE is blocked until it has run >= 1.5 s.

## 4. Ring latch / servo trip (`calc/latch.py`)

Cocked torque at 5 m: 12.97 N m -> catch force 282 N on the 608 roller. Over-centre (toggle) latch on the cocking ring; steel nose dowel; servo MG996R.

| case | e mm (closing) | closing moment N m | finger force worst N | servo torque needed best/nom/worst N m | MG996R margin worst | (MG90S margin) | trip rotation deg |
|---|---|---|---|---|---|---|---|
| min_e | 1.0 | 0.282 | 9.3 | 0.097/0.118/0.139 | **6.6x** | 1.3x | 1.5 |
| nom | 1.5 | 0.423 | 11.6 | 0.132/0.153/0.174 | **5.3x** | 1.0x | 2.3 |
| max_e | 2.0 | 0.564 | 14.0 | 0.167/0.188/0.209 | **4.4x** | 0.8x | 3.1 |

Self-locking at e_min: **True** (holds with power off). The toggle cuts the force needed to release by 20x versus pulling a plain hook off the roller (282 N). An MG90S would not have a 2x margin, so the latch uses an MG996R; safety-pin shear if the servo is forced with the pin in: 14.0 N.

## 5. Hand stress checks (`calc/stress.py`)

PETG: sut_xy=34.0 MPa, sut_z=19.0 MPa (Z = 56% of XY), fatigue S/UTS=0.6 at 1e3 cycles, sustained-stress limit 25% UTS. Absorber impact speed at 5 m: 2.49 m/s (AC1416-1 max 2.6 m/s).

| part | case | load | stress MPa | dir | SF static | SF fatigue | SF creep | min SF | pass |
|---|---|---|---|---|---|---|---|---|---|
| arm | swing, 5 m | F_t=38 N, M=10.5 N m, Z=5662 mm3 | 1.86 | xy | 18.3 | 11.0 | - | **11.0** | PASS |
| arm | absorber stop, 5 m | E=5.46 J, F_abs=444 N, M=42.0 N m | 7.42 | xy | 4.6 | 2.7 | - | **2.7** | PASS |
| arm | DRY FIRE (accidental), 5 m | E=15.4 J (absorber max 20.0 J), M=104.5 N m | 18.46 | xy | 1.8 | - | - | **1.8** | PASS (accidental, need >=1) |
| cup | centripetal envelope (330 @5 m, 500 @3.3 m) | F=84 N | 4.09 | xy | 8.3 | 5.0 | - | **5.0** | PASS |
| cup | socket screw bearing (2 x M3, 2 cheeks x 15.8 mm) | F=38 N | 0.20 | xy | 169.6 | 101.8 | - | **101.8** | PASS |
| hub_drum / arm / hub_catch | dowel bearing at the joints (3 x 4 mm, 10 mm) | T=13.0 N m -> 228 N per dowel | 5.69 | xy | 6.0 | 3.6 | - | **3.6** | PASS |
| hub | bearing seat, cocked 5 m | F=516 N | 1.68 | xy | 20.3 | 12.2 | - | **12.2** | PASS |
| pivot shaft | cocked 5 m | F=516 N, a=69 mm | 354.31 | steel | 3.4 | - | - | **3.4** | PASS |
| side plate | shaft boss bearing, cocked 5 m | F/2=258 N | 2.02 | xy | 16.9 | 10.1 | - | **10.1** | PASS |
| side plate | root bending, cocked 5 m | F_h/2=141 N | 0.46 | xy | 73.9 | 44.4 | - | **44.4** | PASS |
| motor pinion (steel, bought) | peak cocking torque | Ft=134 N | 9.04 | steel | 27.7 | - | - | **27.7** | PASS |
| dog ring gear | peak cocking torque | Ft=134 N | 6.22 | xy | 5.5 | 3.3 | - | **3.3** | PASS |
| ring latch | nose bending, cocked 5 m | F_c=282 N | 4.18 | xy | 8.1 | 4.9 | - | **4.9** | PASS |
| ring latch | pivot hole bearing (4 mm dowel, 10 mm) | F=282 N | 7.05 | xy | 4.8 | 2.9 | - | **2.9** | PASS |
| ring latch | nose dowel hole bearing (4 mm dowel, 10 mm) | F=282 N | 7.05 | xy | 4.8 | 2.9 | - | **2.9** | PASS |
| dog ring gear | latch-pin boss (pin in 2 cheeks, 2 x 8 mm) | F=282 N | 4.41 | xy | 7.7 | 4.6 | - | **4.6** | PASS |
| base rear | M6 adjuster rod bearing on anchor wall, cocked 5 m | F=216 N | 3.60 | xy | 9.4 | 5.7 | 3.9 | **3.9** | PASS |
| base rear | anchor wall shear-out | F=216 N | 1.56 | xy | 21.8 | 13.1 | 9.0 | **9.0** | PASS |
| spring yoke | bending between rods | F=432 N | 4.61 | xy | 7.4 | 4.4 | 3.0 | **3.0** | PASS |
| base front | redirect pulley cheeks (2 x 8 mm) | F=611 N | 4.78 | xy | 7.1 | 4.3 | 2.9 | **2.9** | PASS |
| stop bracket | absorber reaction, 5 m shot (cantilever bending) | F=444 N peak | 2.00 | xy | 17.0 | 10.2 | 19.1 | **10.2** | PASS |
| stop bracket | DRY FIRE | F=1255 N | 5.67 | xy | 6.0 | - | - | **6.0** | PASS (accidental, need >=1) |
| Dyneema cord 2 mm | cocked 5 m | T=432 N | 432.39 | line | 5.6 | - | - | **5.6** | PASS |

## 6. Button (`calc/button.py`)

| sleep consumer | uA |
|---|---|
| ESP32-C3 chip deep sleep (RTC timer off, GPIO wake) | 5.0 |
| ME6211 LDO quiescent (SuperMini) | 40.0 |
| TP4056+DW01A board, battery side (no USB) | 5.0 |
| Battery divider 2 x 1 MOhm | 2.0 |
| Switch pull-up 1 MOhm (open switch) | 0.0 |
| Haptic NPN / LED leakage | 0.2 |
| **total** | **52.2** |

Per press: 8.0 uAh; per day (5 presses): 1.293 mAh + self-discharge 0.822 mAh -> **6.2 months** on 500 mAh x 80% usable. SuperMini red power LED must be desoldered (it draws ~1 mA otherwise) [E2].

Cap springs: 4 x k=0.120 N/mm -> rest 0.72 N, actuation **4.32 N**, bottomed 4.66 N; solid length 4.0 mm < compressed 10.5 mm (no coil bind).

## Gate 2 checklist

| check | value | result |
|---|---|---|
| Peak height <= 2.3 m (5 m shot) | 1.963 | PASS |
| Catch speed <= 4 m/s at 4 m | 5.821 | **FAIL** |
| Press->launch <= 2.5 s at 4 m | 2.420 | PASS |
| Press->launch <= 2.5 s at 5 m | 2.863 | **FAIL** |
| Cycle <= 8 s | 3.539 | PASS |
| Motor < 90% stall at 5 m | 0.796 | PASS |
| Servo trip margin >= 2 (worst mu, max e) | 4.403 | PASS |
| Latch self-locking at min e | 1.000 | PASS |
| Min SF (non-accidental) >= 2.5 | 2.749 | PASS |
| Dry-fire min SF >= 1 and absorber energy <= 20 J | 1.842 | PASS |
| Battery >= 3 months | 6.220 | PASS |
| Cap actuation 3-5 N | 4.324 | PASS |
| Springs <= 85% Fn at 5 m (330 ml) | 0.865 | **FAIL** |
