cameronmorgzz-web/OpenFrontIOmobile/firmware/common/src/sha256.cpp

#include "sha256.h"

#include <cstring>

namespace beer {
namespace {

constexpr uint32_t kK[64] = {
    0x428a2f98, 0x71374491, 0xb5c0fbcf, 0xe9b5dba5, 0x3956c25b, 0x59f111f1, 0x923f82a4, 0xab1c5ed5,
    0xd807aa98, 0x12835b01, 0x243185be, 0x550c7dc3, 0x72be5d74, 0x80deb1fe, 0x9bdc06a7, 0xc19bf174,
    0xe49b69c1, 0xefbe4786, 0x0fc19dc6, 0x240ca1cc, 0x2de92c6f, 0x4a7484aa, 0x5cb0a9dc, 0x76f988da,
    0x983e5152, 0xa831c66d, 0xb00327c8, 0xbf597fc7, 0xc6e00bf3, 0xd5a79147, 0x06ca6351, 0x14292967,
    0x27b70a85, 0x2e1b2138, 0x4d2c6dfc, 0x53380d13, 0x650a7354, 0x766a0abb, 0x81c2c92e, 0x92722c85,
    0xa2bfe8a1, 0xa81a664b, 0xc24b8b70, 0xc76c51a3, 0xd192e819, 0xd6990624, 0xf40e3585, 0x106aa070,
    0x19a4c116, 0x1e376c08, 0x2748774c, 0x34b0bcb5, 0x391c0cb3, 0x4ed8aa4a, 0x5b9cca4f, 0x682e6ff3,
    0x748f82ee, 0x78a5636f, 0x84c87814, 0x8cc70208, 0x90befffa, 0xa4506ceb, 0xbef9a3f7, 0xc67178f2};

inline uint32_t rotr(uint32_t x, unsigned n) { return (x >> n) | (x << (32u - n)); }

}  // namespace

void Sha256::reset() {
  h_[0] = 0x6a09e667;
  h_[1] = 0xbb67ae85;
  h_[2] = 0x3c6ef372;
  h_[3] = 0xa54ff53a;
  h_[4] = 0x510e527f;
  h_[5] = 0x9b05688c;
  h_[6] = 0x1f83d9ab;
  h_[7] = 0x5be0cd19;
  buf_len_ = 0;
  total_len_ = 0;
}

void Sha256::compress(const uint8_t block[kBlockLen]) {
  uint32_t w[64];
  for (int i = 0; i < 16; ++i) {
    w[i] = (static_cast<uint32_t>(block[4 * i]) << 24) | (static_cast<uint32_t>(block[4 * i + 1]) << 16) |
           (static_cast<uint32_t>(block[4 * i + 2]) << 8) | static_cast<uint32_t>(block[4 * i + 3]);
  }
  for (int i = 16; i < 64; ++i) {
    const uint32_t s0 = rotr(w[i - 15], 7) ^ rotr(w[i - 15], 18) ^ (w[i - 15] >> 3);
    const uint32_t s1 = rotr(w[i - 2], 17) ^ rotr(w[i - 2], 19) ^ (w[i - 2] >> 10);
    w[i] = w[i - 16] + s0 + w[i - 7] + s1;
  }
  uint32_t a = h_[0], b = h_[1], c = h_[2], d = h_[3], e = h_[4], f = h_[5], g = h_[6], h = h_[7];
  for (int i = 0; i < 64; ++i) {
    const uint32_t S1 = rotr(e, 6) ^ rotr(e, 11) ^ rotr(e, 25);
    const uint32_t ch = (e & f) ^ (~e & g);
    const uint32_t t1 = h + S1 + ch + kK[i] + w[i];
    const uint32_t S0 = rotr(a, 2) ^ rotr(a, 13) ^ rotr(a, 22);
    const uint32_t maj = (a & b) ^ (a & c) ^ (b & c);
    const uint32_t t2 = S0 + maj;
    h = g;
    g = f;
    f = e;
    e = d + t1;
    d = c;
    c = b;
    b = a;
    a = t1 + t2;
  }
  h_[0] += a;
  h_[1] += b;
  h_[2] += c;
  h_[3] += d;
  h_[4] += e;
  h_[5] += f;
  h_[6] += g;
  h_[7] += h;
}

void Sha256::update(const uint8_t* data, size_t len) {
  total_len_ += len;
  while (len > 0) {
    const size_t take = (kBlockLen - buf_len_) < len ? (kBlockLen - buf_len_) : len;
    std::memcpy(buf_ + buf_len_, data, take);
    buf_len_ += take;
    data += take;
    len -= take;
    if (buf_len_ == kBlockLen) {
      compress(buf_);
      buf_len_ = 0;
    }
  }
}

void Sha256::finish(uint8_t out[kDigestLen]) {
  const uint64_t bit_len = total_len_ * 8u;
  const uint8_t pad80 = 0x80;
  const uint8_t zero = 0x00;
  update(&pad80, 1);
  while (buf_len_ != 56) update(&zero, 1);
  uint8_t len_be[8];
  for (int i = 0; i < 8; ++i) len_be[i] = static_cast<uint8_t>(bit_len >> (56 - 8 * i));
  update(len_be, 8);
  for (int i = 0; i < 8; ++i) {
    out[4 * i] = static_cast<uint8_t>(h_[i] >> 24);
    out[4 * i + 1] = static_cast<uint8_t>(h_[i] >> 16);
    out[4 * i + 2] = static_cast<uint8_t>(h_[i] >> 8);
    out[4 * i + 3] = static_cast<uint8_t>(h_[i]);
  }
  reset();
}

void Sha256::hash(const uint8_t* data, size_t len, uint8_t out[kDigestLen]) {
  Sha256 s;
  s.update(data, len);
  s.finish(out);
}

}  // namespace beer
