cameronmorgzz-web/OpenFrontIOmobile/(commit log)

2026-10-25 Parametric CAD (launcher + button), geometry checks, exports, renders; firmware
    Claude-Session: https://claude.ai/code/session_0167d6wLWLpL4rdGHrfFxkaZ
    [arm.step, arm.stl, base_front.step, base_front.stl, base_rear.step, base_rear.stl, btn_cap.step, btn_cap.stl]
2026-10-25 Simulation models (MuJoCo launch, MC, FEA); design fixes found by FEA/sim
    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
    [arm.step, arm.stl, base_front.step, base_rear.step, btn_cap.step, btn_foot_ring.step, btn_shell.step, btn_switch_plate.step]
2026-10-25 Escapement: toggle-drive seesaw with pre-stage; feed sim 1500/1500 single feeds
    Direct servo drive was back-driven by the can column; a horn + pushrod toggle
    locks at hold. Wider column guides remove a yaw wedge jam; f2 tip sits below
    the rail at hold; lever ratio 1.2 stops double feeds. Firmware stages the
    escapement during COCK (new Escapement::Stage), cutting feed time to 0.6 s.
    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
    [config.h, hal_esp32.cpp, launcher_sm.cpp, launcher_sm.h, motor.py]
2026-10-26 Escapement drive CAD, creep-checked FEA, tests, BOM, electronics, docs
    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
    [BOM.csv, arm.step, base_front.step, base_front.stl, base_rear.step, btn_cap.step, btn_foot_ring.step, btn_shell.step]
2026-10-26 Phase 6: independent review fixes, final sims, docs, build-guide page
    - button never re-fires on a held/stuck switch (timer wake)
    - gear guard hood over the pinion mesh; guard and motor cover fastened
    - FIRE waits for the escapement to settle; servos start 300 ms apart
    - cup reinforced for the simulated peak can acceleration; latch and
    pulley bracket sized for the 24 h cocked creep case
    - switch/sensor brackets, BOM corrections, safe-release procedure
    - final Monte Carlo, FEA, feed sim; 221 tests pass
    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
    [BOM.csv, arm.step, base_front.step, base_front.stl, base_rear.step, btn_cap.step, btn_foot_ring.step, btn_shell.step]
2026-10-26 Add physics video: MuJoCo launch model with CAD meshes (make video)
    sim/launch.py gains an optional per-step trace (physics unchanged; checked
    against an untraced run). sim/video.py renders real time + 20x slow motion.
    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
